jrsphoto/clevercoffee-teensy/teensy-pinout-review.md

# Teensy 4.1 pinout review (Argenta SME control board)

Phase 0 of the CleverCoffee to Teensy 4.1 + ESP32-S3 port. Reviews the Teensy pin
assignments drafted in the KiCad schematic
`clevercoffee-hardware/CleverCoffee_Teensy41_Dev_SMD/` (root sheet +
`relays.kicad_sch`), verified against the real Teensy 4.1 peripheral map. Completed and
ERC-clean 2026-10-26. This table is the source of truth for `src/hardware/pinmapping.h`.

## Method

The schematic was read as a netlist (pins matched to global labels by coordinate), not
eyeballed from the PNG. Every bus assignment was cross-checked against the Teensy core
source (PaulStoffregen/cores `teensy4/pwm.c` for the FlexPWM/QuadTimer table,
PaulStoffregen/SPI for the LPSPI4 default pins) and against the symbol's own pin-name
labels, which are taken from PJRC's pinout card.

## Final pin table (= pinmapping.h)

Teensy digital pin numbers.

| Function | Teensy pin | Peripheral used |
|---|---|---|
| Heater SSR (to ULN2003 I1) | 2 | GPIO out |
| Fill valve (to ULN2003 I4) | 3 | GPIO out |
| Group valve (to ULN2003 I3) | 5 | GPIO out |
| Pump PWM (to driver board; AC mode via Pmode jumper to ULN2003 I2) | 9 | FlexPWM2_2_B |
| Flow sensor (DM60 pulse) | 10 | QuadTimer1_0 (interrupt / input-capture) |
| SPI MOSI (both MAX31865 RTDs) | 11 | SPI (LPSPI4) MOSI |
| SPI MISO (both RTDs) | 12 | SPI MISO |
| SPI SCK (both RTDs) | 13 | SPI SCK (also onboard LED) |
| Boiler RTD chip-select | 15 | GPIO |
| Group RTD chip-select | 16 | GPIO |
| I2C SDA (encoder, PCF8574, pressure) | 18 | Wire (I2C0) SDA |
| I2C SCL (same three) | 19 | Wire (I2C0) SCL |
| Brew switch | 24 | GPIO in |
| Encoder interrupt (ENC_INT) | 25 | GPIO in (R13 pull-up) |
| Water-level probe | 26 | GPIO in (R14 pull-up) |
| HX711 data 1 (SC_DAT) | 38 | GPIO in |
| HX711 clock (SC_CLK, shared) | 39 | GPIO out |
| HX711 data 2 (SC_DAT2) | 40 | GPIO in |
| ESP32-S3 link RX (Serial1 RX1) | 0 | UART |
| ESP32-S3 link TX (Serial1 TX1) | 1 | UART |

Spare pins: D4, D6, D7, D8 (freed by removing the OLED; D7/D8 = Serial2 if a second UART
is ever wanted), plus D14, D17, D20-D23, D27-D37, D41, and the analog-only A-pins.

## Why these are correct

- All hardware buses sit on their native Teensy pins: SPI on 11/12/13, I2C (Wire) on
  18/19, Serial1 on 0/1. The RTD chip-selects (15, 16) and the native hardware CS (10,
  reused here for flow) are fine because any GPIO works as a software SPI chip-select.
- Teensy 4.1 has no boot/strapping-sensitive pins among 0-54, and its onboard SD card and
  QSPI flash are on dedicated pads that do not touch pins 0-54. No assignment collides
  with the SD or flash, and there are no boot-gotcha pins to design around.
- D10 for flow is a good pick: it is QuadTimer1_0, so it supports hardware input-capture,
  not just attachInterrupt. The DM60 runs under ~1 kHz, so even plain interrupts suffice.
- D13 doubles as the onboard LED. Standard on Teensy; the LED flickers with SPI traffic,
  which is harmless.

## Findings and how they were resolved

1. **No ESP32-S3 link pins (blocker).** The schematic had no UART anywhere. Resolved:
   added Serial1 on the free D0/D1 pair (Teensy D1 TX1 to ESP32 RX; Teensy D0 RX1 from
   ESP32 TX). Both 3.3 V, no level shifter.

2. **Pump PWM had no default-off bias (safety).** The four ULN2003 outputs are held off
   at boot by input pull-downs R15-R18, but the PWM pump path bypasses the ULN2003 and had
   no pull-down, so the driver board would see a floating input from power-on until
   firmware takes over. Resolved: added a pull-down on the PMP_PWM net. (Teensy pins power
   up as floating inputs, so this bias is what guarantees "pump off at boot.")

3. **SPI OLED was a leftover from the ESP32 Rev 1.2 board.** The new architecture puts the
   color LCD on the ESP32-S3 module; the Teensy's status indicator is the encoder RGB LED.
   Resolved: removed DISPLAY1 and its four nets, freeing D4, D6, D7, D8.

4. **Pump PWM shared a FlexPWM submodule with the old OLED backlight.** D9 (pump) is
   FlexPWM2_2_B and D6 (OLED_BL) was FlexPWM2_2_A, the same submodule, so the two would
   have shared one PWM frequency. Resolved by finding 3 (OLED removed, D6 freed), so the
   pump now owns FlexPWM2_2 alone. If a second PWM load is ever needed, these are on
   separate submodules and safe alongside the pump: D4 (FlexPWM2_0), D28/D29 (FlexPWM3_1).

## ERC notes (schematic power-pin typing)

The Teensy module sources 3.3 V on-board, which confused ERC until the power-pin types
were set correctly. The rule: every supply/ground net needs exactly one declared source,
which is either one pin set to "Power output" or one PWR_FLAG. Final state:

- **+3.3 V:** one Teensy 3V3 pin set to "Power output" (the regulator source), the other
  3V3 pins set to Passive. No PWR_FLAG needed on this rail.
- **+5 V and GND:** sourced from the power-in connector and declared by the existing
  PWR_FLAGs there. All chip GND pins stay "Power input."
- **+24 V:** appears only on the ULN2003 output/COM side and the relay headers (24 V never
  touches a Teensy pin).

Pin electrical types, in plain terms: "Power output" = supplies a voltage (one per rail);
"Power input" = consumes a supply, which is every chip VDD and every GND pin; "Passive" =
a plain connection point and the spare duplicate supply pads of a module.

## Verified on real hardware (2026-10-26)

The output pins were checked physically with a Kingst LA2016 logic analyzer on the
bench machine (`ssh bench`, `sigrok-cli -d kingst-la2016`), probing a Teensy 4.1
driven by the phase 2a bring-up console. This is the difference between the firmware
claiming a pin number and the pin actually moving, and it was done before the PCB was
fabricated, when a swap still costs nothing.

Probes: CH0 to pin 2, CH1 to pin 3, CH2 to pin 5, CH3 to pin 9, plus a ground lead to
Teensy GND (essential - the Teensy and the analyzer hang off two different computers,
so they need a shared ground reference).

**Test 1 - each channel commanded on for 2 s in turn.** Captured 20 s at 100 kHz:

```
   5.120s  1,0,0,0     on heater -> pin 2       high 2.002 s
   7.122s  0,0,0,0     off
   8.123s  0,1,0,0     on fill   -> pin 3       high 2.002 s
  10.125s  0,0,0,0     off
  11.126s  0,0,1,0     on valve  -> pin 5       high 2.003 s
  13.129s  0,0,0,0     off
  14.130s  0,0,0,1     on pump   -> pin 9       high 2.002 s
  16.132s  0,0,0,0     off
```

Every command drove exactly the intended pin and no other. **No pins are swapped**, in
either the firmware or the schematic. Only ever one channel high at a time, so the
console's one-at-a-time interlock is confirmed at the physical level rather than just
in its own status output. Hold times match the commanded 2.000 s to within 3 ms (serial
latency). Across 20 s on four channels there were exactly eight edges and no spurious
transitions, glitches or cross-talk.

**Test 2 - outputs across a reset.** Captured 25 s spanning a reset, a full reflash and
the reboot:

```
   0.000s  0,0,0,0     ... and nothing else, for the entire capture
histogram: 2,499,841 samples   all 0,0,0,0
```

Zero transitions through the running firmware, the reset into the bootloader, the flash
programming, the reboot, static initialization, `setup()`, and into the main loop. This
physically confirms the claim made in `outputs.cpp` and `safetyHandler.h`: there is no
instant at which an output is undefined or momentarily energized. Previously that was
reasoning about the i.MX RT's GPIO reset state plus the board's pulldowns; now it is
measured.

Pump PWM verified this way on 2026-11-02, with the DRV8871 connected and the
LA2016 on CH3 (Teensy D9), sampling at 10 MHz:

| commanded | measured duty | frequency |
|---|---|---|
| 10% | 10.07% | 20.14 kHz |
| 20% | 19.96% | 19.96 kHz |
| 35% | 35.10% | 19.84 kHz |
| 50% | 49.61% | 19.84 kHz |
| 75% | 75.41% | 19.67 kHz |
| 100% | static HIGH, no switching | - |

Every level within ~0.4% of commanded, and 100% correctly collapses to a
continuous high rather than a 99.98% duty. The frequency sits 0-2% under 20 kHz,
which is FlexPWM prescaler/modulus quantisation and of no consequence.

Note for anyone re-running this: the analyser enumerated as
`kingst-la2016:conn=1.16`, not the `conn=1.9` recorded in earlier notes. Scan
with `sigrok-cli --scan` rather than trusting a stored connection string.

Not yet verified this way (needs the hardware): the two RTD
chip-selects on the shared SPI bus, I2C traffic to the encoder and PCF8574, and DM60
pulse counting. Note the LA2016 also has two PWM *outputs*, which can inject synthetic
flow pulses at a known rate into pin 10 - that makes the net-new DM60 flow handler
testable dry, with no pump or plumbing.

## KiCad changes made (for the record)

1. Added a Conn_01x04 link connector; global labels UART_TX on Teensy D1, UART_RX on D0;
   connector pins labelled UART_TX (to ESP32 RX), UART_RX (to ESP32 TX), +3V3, GND.
2. Added a 10k pull-down (R19) from the pump PWM net to GND near the PUMP_PWM1 header.
3. Removed the DISPLAY1 connector, its decoupling cap, and the OLED_CS/DC/RST/BL labels.
4. Set the Teensy 3V3 regulator pin to "Power output" and the other 3V3 pins to Passive.
5. **Renamed the header-end pump label PMP_PWM to PUMP_PWM (2026-10-31).** See below.

## Found later: the pump PWM net was broken in two

Caught while writing the pump firmware, NOT during this review, which is the
part worth learning from.

The pump path had a global label at each end with a different name: `PUMP_PWM`
on the Teensy D9 side and `PMP_PWM` at the `PUMP_PWM1` header. Global labels
connect by exact name, so those were two separate nets and **D9 never reached
the driver header** - the pump would not have run at all on a fabricated board.
The 10k pull-down was also stranded on the header-side net, leaving the Teensy
pin with no default-off bias.

Fixed by renaming the header-end label to `PUMP_PWM`. Verified in the saved
file: the name now appears twice, `PMP_PWM` is gone, and R19 pulls the whole
net - including D9 - low at reset.

**Why this review missed it:** the review checked pin ASSIGNMENTS against the
Teensy's peripheral map - is D9 really FlexPWM2_2_B, does anything else share
that submodule - and never checked net CONNECTIVITY. A pin can be assigned
perfectly and still be wired to nothing. Any future pinout review should trace
each signal end to end and confirm both ends land on the same net name, not just
that the pin choice is sound.

The same check found two more labels on nets of their own with nothing driving
them, `PMP_AC` and `PMP_RL` in the relays sheet. Those are the remains of the
abandoned on/off pump path and are harmless, but can be deleted for tidiness
now that the pump is PWM-only.

## FIXED 2026-11-05: R10, R9 and the 5 V pin are all resolved

Re-read from the saved schematic files, not assumed:

| item | was | now |
|---|---|---|
| R10, flow sensor pull-up | 47K | **4K7** |
| R9, brew switch pull | 47K, with JP2 solder jumper | **10K pull-down, JP2 deleted, C5 on the signal** |
| `PUMP_PWM1` header | 3-pin, +5 V next to D9 | **2-pin JST XH, 5 V pin removed** |

All three pre-fab blockers below are therefore closed. The sections are kept
because the reasoning is worth having, but **do not act on them as if they were
outstanding.**

Still open from the sections below: nothing. The board has no known pre-fab
blockers as of 2026-11-05.

## FOUND AND FIXED 2026-11-05: the ULN2003 inputs were swapped

A fourth class of fault, and the one this review was least equipped to catch.

The three signals arrived at the wrong ULN channels. Pin assignment was
correct, every net was connected at both ends, and every component value was
right - and it was still wrong, because a multi-channel device pairs input N
with output 17-N and the nets did not respect that pairing. The result was a
three-way rotation: the heater pin would have opened the fill solenoid, the
group valve pin would have fired the heater SSR, and the fill pin would have
opened the group valve.

John fixed it on the spot. Verified correct afterwards by tracing the saved
file:

| ULN channel | input pin | net in | output pin | net out | connector |
|---|---|---|---|---|---|
| 1 | 1 (I1) | `GROUP` | 16 (O1) | `GRP_RL` | `GRP_SOL1` group valve |
| 2 | 2 (I2) | `FILL` | 15 (O2) | `FILL_RL` | `BLR_FILL1` fill solenoid |
| 3 | 3 (I3) | `HEATER` | 14 (O3) | `HTR_RL` | `HEATER_RL1` heater SSR |

Pulldowns confirmed on all three inputs: R15 on `GROUP`, R16 on `FILL`, R17 on
`HEATER`, all to the GND rail. Channels 4-7 are marked no-connect at both ends.
R18 no longer exists, which is correct now that the pump is PWM-only and only
three channels are in use.

**Why the earlier verification missed it.** The LA2016 test recorded further up
this document probed **Teensy pins 2, 3, 5 and 9 directly**. It proved the
firmware drove the pin it meant to, which was the question being asked, and it
could not have caught this because it never looked at the far side of the ULN.
The bench `ulntest` does exercise the output stage, but on hand-wired
breadboard connections rather than the PCB's netlist.

**The check to add to any future review:** for every multi-channel part, confirm
the input and output of the SAME channel carry the same signal. Four things to
check now, not three: pin assignment, net connectivity, component values
against the connected part's datasheet, and **channel pairing through
multi-channel devices.**

## Reasoning kept for the record: R10, the flow sensor pull-up, was 47k

The DM60's datasheet requires a pull-up of **1.2k to 4.7k** on its
open-collector signal pin, depending on supply voltage. R10 on this board is
**47k** - between 10 and 40 times too weak.

Consequence, measured on the breadboard with the Teensy's own ~22k internal
pull-up standing in: the signal line sits LOW permanently. The sensor's output
transistor pulls it down, and the weak pull-up cannot bring it back up between
pulses, so there is no high state to fall from and the falling-edge interrupt
almost never fires. With water flowing at a good rate the firmware counted
**4 pulses in 30 seconds**, against an expected ~40,000 pulses per litre. One
earlier run managed 215 pulses in 12 s, which is the same fault succeeding
marginally for a moment.

Nothing was wrong with the sensor, the wiring, the pump or the firmware. The
firmware counted every edge it was given, with zero debounce rejections
throughout.

**Fix:** change R10 from 47K to **2.2k**. It is already correctly placed between
+3.3 V and the FLOW net; only the value changes.

The rest of that connector is right and worth keeping: `FLOW_SENS1` feeds the
sensor +5 V while the pull-up goes to +3.3 V. That is the correct arrangement
for an open-collector output driving a pin that is not 5 V tolerant - the output
only ever sinks, so the line's high level is set by the 3.3 V pull-up and never
by the sensor's supply.

Related, not broken but worth revisiting: **R9** (brew switch pull) is also 47k,
where most other inputs on this board use 10k. A panel switch on a long lead in
a cabinet with a pump and a 1500 W heater deserves the stronger pull plus a
100 nF to ground.

**How this was missed twice:** the phase-0 review checked pin assignments and,
after the pump-net episode, net connectivity. It never checked component VALUES
against the connected part's datasheet. A pull-up can be present, correctly
placed, correctly connected, and still be the wrong value - which looks
identical to a dead sensor.

## Brew switch block, as revised 2026-11-02

JP2 deleted, R9 now 10k, C5 moved onto the signal. Final arrangement:

    R9  10k    BREW_SW -> GND      (pull-down)
    C5  0.1uF  BREW_SW -> GND      (near the connector)
    BPSW_SW1   pin1 BREW_SW, pin2 +3.3V, pin3 GND
    panel switch wired between pin 1 and pin 2

Three reasons this beats the original 47k + solder-jumper version:

1. **The solder jumper was a silent hazard.** `SolderJumper_3_Open` ships with
   no pads bridged, so a missed build step left pin 24 with NO pull at all -
   a floating input on the signal that starts a brew. Hard-wiring removes a
   step whose omission is dangerous rather than merely wrong.

2. **Pull-down fails safe on the likelier cable fault.** The line idles low and
   the switch pulls it high, so a lead chafing against grounded chassis metal -
   far more likely inside a machine than shorting to a 3.3 V wire - reads as
   NOT PRESSED. Wired the other way, that same chafe starts a shot.

3. **C5 earns its keep now.** It was decoupling the 3.3 V pin feeding a passive
   mechanical switch drawing 0.33 mA, which needed nothing. On the signal with
   10k it gives a 1 ms time constant - inside the 20 ms firmware debounce, so
   it filters induced spikes without making the switch feel slow.

The switch also uses adjacent connector pins (1 and 2), keeping the cable's
current loop tight.

**FIRMWARE CONSEQUENCE, to action when the board is built:** this board is
external pull-DOWN, active HIGH. `switchHandler` currently defaults to the
Teensy's INTERNAL pull-up and active LOW, because the breadboard has no
external resistor on this signal. When the PCB exists, change the defaults to
`Pull::External` and `setActiveHigh(true)`, or set them at runtime with
`brewpull x` then `brewsense`.

## Pull-up audit: every pin where firmware depends on a pull

Done after John asked whether anywhere the code uses an internal pull-up ought
to have an external one instead. Good instinct, and the answer is more specific
than "yes": the board already HAS external pulls nearly everywhere. Two of them
are simply the wrong value.

| Pin | Signal | External | Value | Verdict |
|-----|---|---|---|---|
Values below are as re-read from the saved schematic on 2026-11-05. The two that
were wrong have been corrected.

| Pin | Signal | External | Value | Verdict |
|-----|---|---|---|---|
| 18/19 | SDA / SCL | R7, R8 | 4k7 | correct for I2C |
| 25 | ENC_INT | R13 | 10k | fine - open-drain, short on-board trace |
| 26 | WATER probe | R14 | 10k | reasonable |
| 10 | FLOW | R10 | 4k7 | **FIXED** - was 47k, datasheet wants 1k2-4k7 |
| 24 | BREW_SW | R9 | 10k | **FIXED** - was 47k, now 10k pull-DOWN + C5 on signal |
| 9 | PUMP_PWM | R19 | 10k | pull-down, default-off bias for the pump |
| 38/40 | HX711 DAT | none | - | **not needed**, see below |

Superseded original table, kept so the "how this was missed" note below still
has something to refer to:

| Pin | Signal | External | Value | Verdict |
|-----|---|---|---|---|
| 10 | FLOW | R10 | **47k** | **WRONG** - datasheet wants 4k7, see above |
| 24 | BREW_SW | R9 | **47k** | weak for a long panel lead; 10k + 100nF better |

The HX711 is a genuine exception. Its DOUT is a push-pull CMOS output that
actively drives both high and low, so a pull-up does nothing for it. The
firmware enables the internal one purely so that an ABSENT board reads as a
defined high - which is what `weight::probeDataLine()` keys off to tell a
missing HX711 from a present one.

**The rule to apply going forward:** anything open-collector or open-drain, and
anything arriving on a cable from off-board, needs an external pull-up of a
chosen value. Teensy 4's `INPUT_PULLUP` is 22k (the core writes `PUS(3)` in
digital.c), which is adequate for a short on-board open-drain line and nowhere
near enough for a sensor whose datasheet specifies 4k7. An internal pull is a
default, not a design decision.

## RESOLVED: 5 V next to a 3.3 V-only pin

`PUMP_PWM1` is a 3-pin header: pin 1 the PWM signal, pin 2 **+5 V**, pin 3 GND.
The signal pin goes straight to Teensy D9, which is not 5 V tolerant, and it sits
immediately next to a 5 V pin. A connector inserted one position off puts 5 V on
D9 and destroys the pin or the chip.

The DRV8871 needs no logic supply - it runs from VM alone - so if nothing on the
driver board needs 5 V, the cleanest fix is to delete pin 2 and make this a
2-pin header, which removes the hazard rather than mitigating it. If a driver
board does need 5 V, use a polarised connector so it can only mate one way.

**Done, and better than asked.** `PUMP_PWM1` is now a **2-pin JST XH**
(`JST_XH_B2B-XH-A_1x02_P2.50mm_Vertical`), confirmed in the saved file. The 5 V
pin is gone, so the hazard no longer exists, and JST XH is polarised, so the
remaining two pins cannot be mated backwards either. Both fixes rather than one.
