jrsphoto/clevercoffee-teensy/assets/coffee-drink.png

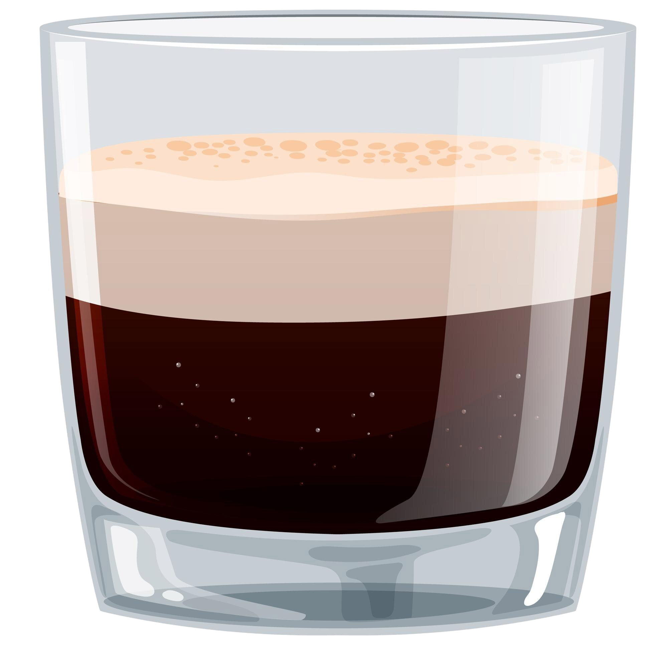
assets/coffee-drink.png
