jrsphoto/clevercoffee-teensy/src/main.cpp

/**
 * @file main.cpp
 *
 * @brief Teensy 4.1 control firmware for the Argenta SME espresso machine
 *
 * PHASE 1 SKELETON. This boots, proves the board is alive, holds everything in a
 * safe state and feeds the watchdog. It deliberately does not yet control
 * anything: the handlers are ported in later phases (see TEENSY-PORT-BRIEF.md).
 *
 * Division of labour, for anyone reading this cold:
 *   - This Teensy owns all real-time control, all physical I/O and ALL safety.
 *   - An ESP32-S3 module over Serial1 owns WiFi, the web UI and the colour LCD.
 *     It is a head only. It holds no actuators and no safety, and the machine
 *     runs and finishes shots normally with it unplugged.
 *
 * Structure follows upstream CleverCoffee on purpose: small hardware interfaces
 * (TempSensor / Relay / Switch / Scale), feature logic in xHandler modules, one
 * setup() and one loop(). The hardware layer underneath is swapped for Teensy
 * and a comms layer is added; the shape stays recognizable so upstream changes
 * remain cross-referenceable.
 */

#include <Arduino.h>

#include "bringupConsole.h"
#include "commsHandler.h"
#include "configStore.h"
#include "encoderHandler.h"
#include "flowHandler.h"
#include "hardware/outputs.h"
#include "hardware/pinmapping.h"
#include "heaterHandler.h"
#include "i2cHandler.h"
#include "pumpHandler.h"
#include "safetyHandler.h"
#include "shotHandler.h"
#include "switchHandler.h"
#include "tempHandler.h"

#ifdef DESK_SIM
    #include "boilerSim.h"
#endif
#include "updateMode.h"
#include "weightHandler.h"

// Version of the Teensy control firmware specifically. Independent of the
// upstream CleverCoffee version carried in VERSION.txt.
constexpr char kTeensyFirmwareVersion[] = "0.1.0-phase1";

namespace {

    /**
     * Serial console on the USB port. Used for bring-up and diagnostics; it is
     * NOT the ESP32 link (that is Serial1) and nothing about control depends on
     * anyone being connected to it.
     */
    constexpr uint32_t kConsoleBaud = 115200;

    /**
     * How long to wait for a USB console at boot before giving up and carrying
     * on. The machine must boot with nothing plugged in, so this is a short
     * courtesy pause for the bench, never a requirement.
     */
    constexpr uint32_t kConsoleWaitMs = 1500;

    /**
     * Main loop pacing. The real control cadence arrives with the PID in phase 3;
     * for now this just keeps the skeleton's heartbeat readable.
     */
    constexpr uint32_t kHeartbeatIntervalMs = 2000;

    uint32_t lastHeartbeatMs = 0;

    /**
     * @brief Power-on checks that must pass before the machine is allowed to do
     *        anything.
     *
     * Phase 1 only knows how to check the things that exist in phase 1. As
     * sensors land in phase 2 this grows: RTD fault flags, a plausible boiler
     * temperature, the water probe reading something valid, the I2C devices
     * acknowledging at their expected addresses.
     *
     * @return true if the machine is fit to run.
     */
    bool runBootSelfCheck() {
        bool ok = true;

        // A watchdog reset means the previous run stopped feeding the loop. That
        // is never normal, and it must be visible rather than silently absorbed
        // into what looks like a fresh power-on.
        if (safetyWasWatchdogReset()) {
            Serial.println("SELF-CHECK: previous run ended in a WATCHDOG RESET");
            safety::latchFault(FaultCode::WatchdogReset, "previous run stalled");
            ok = false;
        }

        // The boiler RTD is the one sensor the heater cannot run safely without.
        // The group probe is deliberately not checked here: it is monitoring
        // only and may not even be fitted.
        if (!temps::selfCheck()) {
            Serial.println("SELF-CHECK: boiler RTD did not return a believable reading");
            safety::latchFault(FaultCode::BootSelfCheck, "boiler RTD unavailable at boot");
            ok = false;
        }
        else {
            Serial.print("SELF-CHECK: boiler RTD reads ");
            Serial.print(temps::boilerC(), 2);
            Serial.println(" C");
        }

        return ok;
    }

    /**
     * Tracks whether a serial monitor is attached, so a fresh connection can be
     * greeted with the banner.
     *
     * The board boots and starts running long before anyone opens a monitor, so
     * anything printed only once at startup is invisible in practice - which is
     * exactly what happened on the bench: upload, open the monitor, see nothing
     * but heartbeats and wonder whether the firmware is alive.
     *
     * On Teensy, `(bool)Serial` reports whether the USB host has the port open
     * (DTR asserted), so a false->true transition is a monitor attaching.
     */
    bool consoleWasAttached = false;

    void printBanner() {
        Serial.println();
        Serial.println("========================================");
        Serial.print("CleverCoffee Teensy control firmware ");
        Serial.println(kTeensyFirmwareVersion);
        Serial.println("Argenta SME - Teensy 4.1 + ESP32-S3");
        Serial.println("========================================");
        Serial.print("Safe state asserted on pins: heater=");
        Serial.print(PIN_HEATER);
        Serial.print(" pump=");
        Serial.print(PIN_PUMP);
        Serial.print(" valve=");
        Serial.print(PIN_VALVE);
        Serial.print(" fill=");
        Serial.println(PIN_FILL);
    }

    /**
     * @brief Report the current fault state in one line.
     */
    void printFaultLine() {
        if (safety::isFaulted()) {
            Serial.print("FAULT LATCHED: ");
            Serial.print(safetyFaultName(safety::latchedFault));
            Serial.print(" (");
            Serial.print(safety::latchedDetail);
            Serial.println(") - outputs blocked, 'clear' to reset");
        }
        else {
            Serial.println("no fault latched - outputs available");
        }
    }

    /**
     * @brief Greet a monitor that has just attached.
     *
     * Re-prints everything a person needs to orient themselves, so opening a
     * monitor at any point gives the full picture rather than a bare heartbeat.
     */
    void onConsoleAttached() {
        printBanner();
        Serial.print("uptime ");
        Serial.print(millis() / 1000);
        Serial.println("s");
        printFaultLine();
        temps::printStatus();
        flow::printStatus();
        switches::printStatus();
        weight::printStatus();
        pump::printStatus();
        heater::printStatus();
        shot::printStatus();
        encoder::printStatus();
        comms::printStatus();
        bringupConsolePrintHelp();
    }

} // namespace

void setup() {
    // FIRST. Before the console, before config, before any object is built.
    // Until this runs, the outputs are held off only by the board's bias
    // resistors; this takes deliberate control of them.
    safetyInitOutputs();

    Serial.begin(kConsoleBaud);

    // Checked before ANYTHING else is initialised, and read-and-cleared so a
    // crash in update mode cannot become a boot loop that stays there.
    //
    // Update mode never arms the watchdog, never starts a sensor and never runs
    // the control loop - a machine being updated is provably not controlling
    // anything, because the code that controls things was never started.
    if (updateMode::consumeRequest()) {
        const uint32_t updateWaitStart = millis();

        while (!Serial && (millis() - updateWaitStart) < kConsoleWaitMs) {
        }

        updateMode::runLoop(); // does not return
    }

    const uint32_t consoleWaitStart = millis();

    while (!Serial && (millis() - consoleWaitStart) < kConsoleWaitMs) {
        // Wait briefly for a bench console, but never block a real boot on it.
    }

    printBanner();

    // Hardware before the self-check, because the self-check tests it.
    //
    // These were previously constructed AFTER runBootSelfCheck(), so the boiler
    // RTD was always still a null pointer when the check ran - it reported the
    // sensor unavailable and latched the machine safe on every single boot, even
    // with a perfectly good probe attached. The ordering is the whole point.
    outputs::init();
    i2c::init();
    temps::init();
    flow::init();
    switches::init();
    weight::init();
    pump::init();
    heater::init();
    shot::init();

    // AFTER every handler's init(), because restoring a setting calls that
    // handler's setter and those have to be ready to receive it. Before
    // comms::init() so the machine is already running the operator's settings
    // when the first telemetry frame goes out, rather than reporting defaults
    // for a moment and then changing its mind.
#ifdef DESK_SIM
    boilersim::init();

    // The dry-fire interlock would otherwise block the heater forever and the
    // model would never warm up. Reuse the EXISTING documented bypass rather
    // than adding a second way through the interlock - one path through that
    // gate is enough, and this one already announces itself loudly. It is
    // honest here: there is no element, and no SSR is even connected.
    heater::setBenchOverride(true);
#endif

    configStore::begin();

    comms::init();

    if (encoder::init()) {
        Serial.println("encoder: found and initialised");
    }
    else {
        Serial.println("encoder: NOT FOUND on the I2C bus");
    }

    if (!runBootSelfCheck()) {
        Serial.print("SELF-CHECK FAILED: ");
        Serial.print(safetyFaultName(safety::latchedFault));
        Serial.print(" (");
        Serial.print(safety::latchedDetail);
        Serial.println(")");
        Serial.println("Machine is LATCHED SAFE. Outputs stay off until the fault is cleared.");
    }
    else {
        Serial.println("SELF-CHECK PASSED");
    }

    // Started last, so a slow but legitimate boot cannot trip it, and before the
    // first loop() so the running machine is always covered.
    safety::noteControlLoopAlive();
    safetyWatchdogInit();

    Serial.println("Watchdog armed. Entering main loop.");

    bringupConsoleBegin();
}

void loop() {
    // Tell the safety layer the control loop is alive and its data is fresh.
    // The heater drive (phase 3) refuses to energize if this goes stale, so a
    // hung loop drops the heater rather than leaving the SSR commanded on.
    safety::noteControlLoopAlive();

    // --- Phase 2 onwards, in roughly this order: -------------------------
    // loopWaterLevel();     // dry-fire interlock, gates the heater
    // loopPressure();       // brew pressure
    // loopFlow();           // DM60 pulse counter -> volume
    // loopEncoder();        // Duppa gestures + RGB machine status
    // loopComms();          // telemetry out, commands in, non-blocking

#ifdef DESK_SIM
    // BEFORE temps::loop(), so the rise this pass adds is current rather than
    // one pass stale. Driven by the real heater output pin - see boilerSim.h.
    boilersim::loop();
#endif

    // Both RTDs. Latches the machine safe on a boiler sensor fault, an
    // implausible boiler reading, an over-temperature, or a boiler reading that
    // has stopped updating.
    temps::loop();

    // DM60 pulse counter -> volume and rate. Counting is interrupt-driven; this
    // only derives the rate and decides when flow has stopped.
    flow::loop();
    flow::serviceWatch();

    // Hardwired brew switch. Reads and debounces only - nothing acts on it
    // until the brew state machine lands in phase 3.
    switches::loop();
    switches::serviceWatch();

    // Pump speed: services the ramp AND the command-expiry rule, so it has to
    // run every pass even when the pump is idle - that is what catches a
    // wedged caller that stopped re-asserting its speed.
    // Boiler PID. Computes continuously; the output is gated and the ISR
    // refuses to energise on a permit this does not keep refreshing.
    heater::loop();
    heater::serviceOutputDutyMeasurement();

    // Brew sequence. Re-asserts the pump every pass on purpose, so a hang
    // here lets the pump's own command expiry stop it.
    shot::loop();

    pump::loop();

    // HX711 load cell. Non-blocking: drives its own stabilise/tare sequence
    // and then one conversion per pass as the chip makes them available.
    weight::loop();

    // Non-blocking encoder INT watch (bring-up aid).
    i2c::serviceEncoderIntWatch();

    // Duppa encoder: gestures and the RGB machine-status LED.
    encoder::loop();

    // Link to the display head. Telemetry out, commands in. Never blocks, and
    // never gates anything - a missing head is not a machine fault.
    comms::loop();

    // Deferred EEPROM write for settings pushed over the link. Coalesces the
    // burst the head sends on handshake into a single write.
    configStore::loop();

    if (safety::isFaulted()) {
        // Belt and braces. The fault path already forced everything off; this
        // re-asserts it every pass so no later code can quietly undo it.
        safetyHardOff();
    }

    // Greet a monitor that has just been opened. Without this the banner is
    // only ever printed at boot, which in practice nobody is connected to see.
    if (const bool consoleAttached = static_cast<bool>(Serial); consoleAttached != consoleWasAttached) {
        consoleWasAttached = consoleAttached;

        if (consoleAttached) {
            onConsoleAttached();
        }
    }

    // Bench bring-up: one output at a time, auto-off, nothing while faulted.
    // Also enforces the auto-off timer, so it must run even when nobody types.
    bringupConsoleLoop();

    // One-line status, repeated so the bench always shows the whole machine.
    //
    // This used to print just "alive, uptime 140s, state safe-idle", which is
    // the worst of both worlds: frequent enough to scroll everything useful out
    // of a serial monitor, while saying nothing you would want to know. Every
    // sensor now reports on the same line, so a monitor opened at any moment
    // shows the current state of the machine without typing anything.
    //
    // Suppressed while a channel is energized from the console, so it cannot
    // scroll an auto-off warning off the screen.
    if (const uint32_t now = millis(); now - lastHeartbeatMs >= kHeartbeatIntervalMs) {
        lastHeartbeatMs = now;

        if (outputs::activeCount() == 0) {
            Serial.print(now / 1000);
            Serial.print("s ");
            Serial.print(safety::isFaulted() ? safetyFaultName(safety::latchedFault) : "safe-idle");

            // Temperatures, with a marker rather than a plausible number when
            // the probe is unhealthy - a bad reading must not look like a good
            // one at a glance.
            Serial.print(" | boiler ");

            if (temps::boilerHealthy()) {
                Serial.print(temps::boilerC(), 1);
                Serial.print("C");
            }
            else {
                Serial.print("FAULT");
            }

            Serial.print(" group ");

            if (temps::groupHealthy()) {
                Serial.print(temps::groupC(), 1);
                Serial.print("C");
            }
            else {
                Serial.print("--");
            }

            Serial.print(" | brew ");
            Serial.print(switches::brewRequested() ? "PRESSED" : "off");

            Serial.print(" | scale ");

            if (weight::healthy()) {
                Serial.print(weight::grams(), 1);
                Serial.print(weight::calFactor() == 1.0f ? " raw" : " g");
            }
            else if (weight::present()) {
                Serial.print("starting");
            }
            else {
                Serial.print("--");
            }

            Serial.print(" | flow ");
            Serial.print(flow::rateMlPerSec(), 1);
            Serial.print(" ml/s ");
            Serial.print(flow::totalMl(), 0);
            Serial.print("ml");

            Serial.print(" | pump ");
            Serial.print(pump::actualSpeed(), 0);
            Serial.print("%");

            Serial.print(" | enc ");
            Serial.print(encoder::counter());

            Serial.print(" | head ");
            Serial.print(comms::peerPresent() ? "ok" : "--");

            Serial.println();
        }
    }

    // Last statement in the loop on purpose: everything above has to have had a
    // chance to run for this pass to count as healthy.
    safetyWatchdogFeed();
}
