jrsphoto/clevercoffee-teensy/src/heaterHandler.cpp

/**
 * @file heaterHandler.cpp
 *
 * @brief Boiler PID and the heater SSR drive
 */

#include "heaterHandler.h"

#include <Arduino.h>
#include <PID_v1.h>

#include "hardware/outputs.h"
#include "hardware/pinmapping.h"
#include "safetyHandler.h"
#include "tempHandler.h"

namespace heater {

    namespace {

        // --- PID state. The library takes pointers, so these must outlive it.
        double pidInput = 0.0;
        double pidOutput = 0.0;
        double pidSetpoint = kDefaultSetpointC;

        double tuneKp = kDefaultKp;
        double tuneTn = kDefaultTn;
        double tuneTv = kDefaultTv;

        double kiFromTn() {
            return (tuneTn == 0.0) ? 0.0 : (tuneKp / tuneTn);
        }

        double kdFromTv() {
            return tuneKp * tuneTv;
        }

        PID bPID(&pidInput, &pidOutput, &pidSetpoint, kDefaultKp, kDefaultKp / kDefaultTn, kDefaultKp * kDefaultTv, 1, DIRECT);

        IntervalTimer windowTimer;

        /**
         * The permit, and the stamp that makes it perishable.
         *
         * Both written by the main loop and read by the ISR. Volatile because
         * of that, and 32-bit so each is read atomically on this core - the ISR
         * can never see half of an update.
         */
        volatile bool permitGranted = false;
        volatile uint32_t permitStampMs = 0;

        /** Duty the ISR compares the tick counter against, 0-1000. */
        volatile uint32_t isrDutyPerMille = 0;

        /** Set once the monitor pin is known to be wired; see armOutputMonitor(). */
        volatile bool ulnMonitorArmed = false;
        volatile uint32_t isrUlnMismatches = 0;

        volatile uint32_t isrTicks = 0;
        volatile uint32_t isrOnTicks = 0;
        volatile uint32_t isrCounter = 0;

        bool masterEnable = false;
        bool benchOverrideOn = false;
        const char* gateReason = "not enabled";

        /**
         * @brief Drive the heater pin directly. ISR-safe.
         *
         * Raw pin writes rather than the Relay object, for the same reason
         * safetyHardOff() uses them: this runs in interrupt context and must
         * not depend on any other part of the firmware being in a good state.
         * The channel is HIGH_TRIGGER through the ULN2003, so HIGH = conducting.
         */
        inline void driveHeater(const bool on) {
            digitalWriteFast(PIN_HEATER, on ? HIGH : LOW);
        }

        /**
         * @brief Window timer tick, every kTickMs.
         *
         * Deliberately tiny and free of anything that could block. It does not
         * evaluate the safety gates - that would mean calling into half the
         * firmware from an interrupt - but it does not blindly trust them
         * either: a permit older than kPermitTimeoutMs is treated as absent, so
         * a main loop that has stopped refreshing it drops the heater without
         * the ISR needing to know why.
         */
        void onTick() {
            ++isrTicks;

            const uint32_t now = millis();
            const bool permitFresh = (now - permitStampMs) <= kPermitTimeoutMs;

            if (!permitGranted || !permitFresh) {
                driveHeater(false);
                isrCounter = 0;

                return;
            }

            // Upstream's comparison, unchanged: the counter walks the window in
            // kTickMs steps and the output is scaled to the same units.
            const bool on = (isrDutyPerMille > isrCounter);

            driveHeater(on);

            if (on) {
                ++isrOnTicks;
            }

            // Verify the output stage on EVERY tick, not just on demand.
            //
            // This replaced a diagnostic that sampled the monitor pin once per
            // main-loop pass and read 13% high - loop timing is not uniform, so
            // samples do not land evenly across the window. Sampling here is
            // exact by construction: one reading per tick, always at the same
            // point after the pin is driven.
            //
            // It also turns a manual test into continuous monitoring. A ULN
            // channel that dies mid-shot now shows up in the mismatch count
            // rather than as a boiler that quietly stops heating.
            if (ulnMonitorArmed) {
                // The Darlington switches in about a microsecond; give it a
                // couple before believing the reading.
                delayMicroseconds(2);

                // Output is inverted: driven high means the output sinks low.
                if ((digitalReadFast(kPinHtrRlMonitor) == LOW) != on) {
                    ++isrUlnMismatches;
                }
            }

            isrCounter += kTickMs;

            if (isrCounter >= kWindowMs) {
                isrCounter = 0;
            }
        }

        /**
         * @brief Evaluate every gate. Main-loop context, so it may do real work.
         *
         * Order matters only for the message: the first failure is what gets
         * reported, so the most fundamental reasons are checked first.
         */
        bool evaluateGates() {
            if (!masterEnable) {
                gateReason = "not enabled ('heater on' to enable)";

                return false;
            }

            if (safety::isFaulted()) {
                gateReason = "fault latched";

                return false;
            }

            if (!safety::boilerSensorHealthy) {
                gateReason = "boiler sensor not healthy";

                return false;
            }

            if (!temps::boilerHealthy()) {
                gateReason = "boiler RTD faulted or stale";

                return false;
            }

            // Belt and braces against the over-temperature limit. tempHandler
            // already latches a fault on this, which gate 2 would then catch -
            // but the heater should not depend on another module having
            // reacted first.
            if (temps::boilerC() >= temps::overTempLimitC()) {
                gateReason = "boiler over temperature";

                return false;
            }

            // DRY-FIRE INTERLOCK. There is no water-level probe circuit yet, so
            // the honest answer to "is there water?" is "unknown", and unknown
            // must mean no. See the header - do not default this to true.
            if (!benchOverrideOn) {
                gateReason = "no water-level probe (dry-fire interlock)";

                return false;
            }

            gateReason = "ok";

            return true;
        }

    } // namespace

    void init() {
        // The pin is already safe - safetyInitOutputs() ran first - but make
        // the ownership explicit before the timer can touch it.
        pinMode(PIN_HEATER, OUTPUT);
        digitalWriteFast(PIN_HEATER, LOW);

        permitGranted = false;
        permitStampMs = 0;
        isrDutyPerMille = 0;
        isrCounter = 0;

        // Upstream's configuration, unchanged. Output is scaled to the window
        // in milliseconds so the ISR can compare it straight against its tick
        // counter without converting anything in interrupt context.
        bPID.SetSampleTime(static_cast<int>(kWindowMs));
        bPID.SetOutputLimits(0, static_cast<double>(kWindowMs));
        bPID.SetIntegratorLimits(0, kDefaultIntegratorMax);
        bPID.SetSmoothingFactor(kDefaultEmaFactor);
        bPID.SetTunings(tuneKp, kiFromTn(), kdFromTv());
        bPID.SetMode(AUTOMATIC);

        windowTimer.begin(onTick, kTickMs * 1000);

        Serial.print("heater: PID ready, setpoint ");
        Serial.print(pidSetpoint, 1);
        Serial.print(" C, window ");
        Serial.print(kWindowMs);
        Serial.print(" ms / ");
        Serial.print(kTickMs);
        Serial.print(" ms tick, OUTPUT DISABLED (");
        Serial.print(gateReason);
        Serial.println(")");
    }

    void loop() {
        // Feed the PID the real temperature regardless of whether the output
        // is allowed to do anything. Running it continuously means the duty it
        // reports is meaningful the instant heating is permitted, and it keeps
        // the whole path exercised while the element is disconnected.
        pidInput = temps::boilerC();
        bPID.Compute();

        const bool allowed = evaluateGates();

        // Publish to the ISR. The duty goes out first so the ISR can never see
        // a fresh permit paired with a stale duty.
        isrDutyPerMille = allowed ? static_cast<uint32_t>(pidOutput) : 0;
        permitGranted = allowed;
        permitStampMs = millis();

        // Nothing re-asserts the output here. If this function stops being
        // called the stamp goes stale and the ISR drops the heater on its own,
        // which is the entire point of the expiry.
    }

    bool setEnabled(const bool on) {
        if (!on) {
            masterEnable = false;
            permitGranted = false;
            isrDutyPerMille = 0;
            driveHeater(false);

            Serial.println("heater: DISABLED");

            return true;
        }

        if (safety::isFaulted()) {
            gateReason = "fault latched";

            Serial.println("heater: REFUSED - clear the latched fault first");

            return false;
        }

        masterEnable = true;

        // Re-evaluate before reporting. gateReason is otherwise a pass behind,
        // so enabling the heater printed "blocked - not enabled" immediately
        // after enabling it. A status line that contradicts the thing you just
        // did teaches people to ignore status lines.
        evaluateGates();

        Serial.println("heater: master enable ON - the other gates still apply");
        printStatus();

        return true;
    }

    bool enabled() {
        return masterEnable;
    }

    void setBenchOverride(const bool on) {
        benchOverrideOn = on;

        if (on) {
            Serial.println();
            Serial.println("*** DRY-FIRE INTERLOCK OVERRIDDEN ***");
            Serial.println("The water-level probe is bypassed. This is for confirming the SSR");
            Serial.println("drive with NO HEATING ELEMENT CONNECTED. Do not leave it set, and");
            Serial.println("do not energise an element in a boiler whose water level is unknown.");
            Serial.println("Not persisted - a reboot clears it.");
            Serial.println();
        }
        else {
            Serial.println("heater: dry-fire interlock restored");
        }
    }

    bool benchOverride() {
        return benchOverrideOn;
    }

    double dutyPercent() {
        return (pidOutput * 100.0) / static_cast<double>(kWindowMs);
    }

    double rawOutput() {
        return pidOutput;
    }

    double setpointC() {
        return pidSetpoint;
    }

    void setSetpointC(const double celsius) {
        // Clamped well under the over-temperature limit. A setpoint above it
        // would mean the PID asking for heat the gates must then refuse -
        // the machine fighting itself, and confusing to debug.
        const double ceiling = temps::overTempLimitC() - 5.0;

        if (celsius < 20.0 || celsius > ceiling) {
            Serial.print("heater: REFUSED - setpoint must be 20 to ");
            Serial.print(ceiling, 1);
            Serial.println(" C");

            return;
        }

        pidSetpoint = celsius;

        Serial.print("heater: setpoint now ");
        Serial.print(pidSetpoint, 1);
        Serial.println(" C");
    }

    void setTunings(const double kp, const double tn, const double tv) {
        tuneKp = kp;
        tuneTn = tn;
        tuneTv = tv;

        bPID.SetTunings(tuneKp, kiFromTn(), kdFromTv());

        Serial.print("heater: tunings Kp ");
        Serial.print(tuneKp, 2);
        Serial.print(" Tn ");
        Serial.print(tuneTn, 2);
        Serial.print(" Tv ");
        Serial.print(tuneTv, 2);
        Serial.print("  (Ki ");
        Serial.print(kiFromTn(), 4);
        Serial.print(" Kd ");
        Serial.print(kdFromTv(), 2);
        Serial.println(")");
    }

    void tunings(double* kp, double* tn, double* tv) {
        *kp = tuneKp;
        *tn = tuneTn;
        *tv = tuneTv;
    }

    bool permitted() {
        return permitGranted;
    }

    const char* blockedBy() {
        return gateReason;
    }

    uint32_t tickCount() {
        return isrTicks;
    }

    uint32_t onTickCount() {
        return isrOnTicks;
    }

    namespace {

        bool measuring = false;
        uint32_t measureUntilMs = 0;
        uint32_t measureTicksAtStart = 0;
        uint32_t measureOnTicksAtStart = 0;
        uint32_t measureMismatchAtStart = 0;
        double measureDutyAsked = 0.0;
        uint32_t measureAskedSamples = 0;

    } // namespace

    void startOutputDutyMeasurement(const uint32_t seconds) {
        pinMode(kPinHtrRlMonitor, INPUT_PULLUP);
        ulnMonitorArmed = true;

        measuring = true;
        measureUntilMs = millis() + (seconds * 1000);
        measureTicksAtStart = isrTicks;
        measureOnTicksAtStart = isrOnTicks;
        measureMismatchAtStart = isrUlnMismatches;
        measureDutyAsked = 0.0;
        measureAskedSamples = 0;

        Serial.print("heater: measuring for ");
        Serial.print(seconds);
        Serial.println("s, counting ISR ticks and checking the ULN on each one...");
    }

    void serviceOutputDutyMeasurement() {
        if (!measuring) {
            return;
        }

        // Only the ASKED duty is sampled from the loop; the measured duty comes
        // from the ISR's own tick counters, which cannot be biased by loop
        // timing the way a loop-rate sampler is.
        measureDutyAsked += dutyPercent();
        ++measureAskedSamples;

        if (static_cast<int32_t>(millis() - measureUntilMs) < 0) {
            return;
        }

        measuring = false;

        const uint32_t ticks = isrTicks - measureTicksAtStart;
        const uint32_t onTicks = isrOnTicks - measureOnTicksAtStart;
        const uint32_t mismatches = isrUlnMismatches - measureMismatchAtStart;

        if (ticks == 0 || measureAskedSamples == 0) {
            Serial.println("heater: no ticks observed - is the timer running?");

            return;
        }

        const double measured = (100.0 * static_cast<double>(onTicks)) / static_cast<double>(ticks);
        const double asked = measureDutyAsked / static_cast<double>(measureAskedSamples);

        Serial.print("  duty ");
        Serial.print(measured, 2);
        Serial.print("% over ");
        Serial.print(ticks);
        Serial.print(" ticks, PID asked ");
        Serial.print(asked, 2);
        Serial.print("%, error ");
        Serial.print(measured - asked, 2);
        Serial.println(" points");

        Serial.print("  ULN output disagreed with the commanded state on ");
        Serial.print(mismatches);
        Serial.print(" of ");
        Serial.print(ticks);
        Serial.println(" ticks");

        if (mismatches == 0) {
            Serial.println("  PASS - the output stage followed every tick.");
        }
        else {
            Serial.println("  *** FAIL - the ULN output did not follow the drive. ***");
        }
    }

    bool testOutputStage() {
        pinMode(kPinHtrRlMonitor, INPUT_PULLUP);

        // Stop the window timer briefly so the ISR cannot fight this test for
        // the pin. Restarted before returning, whatever the outcome.
        windowTimer.end();

        Serial.print("heater: testing the ULN2003 output stage (pin ");
        Serial.print(PIN_HEATER);
        Serial.print(" drives net HEATER -> ULN -> net HTR_RL -> pin ");
        Serial.print(kPinHtrRlMonitor);
        Serial.println(")");

        // Input LOW: the Darlington is off, the output floats, and the
        // internal pull-up should bring the monitor pin high.
        driveHeater(false);
        delayMicroseconds(500);
        const int offState = digitalRead(kPinHtrRlMonitor);

        // Input HIGH: the Darlington conducts and should pull the output to
        // near ground against the pull-up.
        driveHeater(true);
        delayMicroseconds(500);
        const int onState = digitalRead(kPinHtrRlMonitor);

        driveHeater(false);

        windowTimer.begin(onTick, kTickMs * 1000);

        Serial.print("  HEATER low   -> HTR_RL reads ");
        Serial.println(offState == HIGH ? "HIGH (floating, pulled up)  as expected" : "LOW   <-- WRONG");
        Serial.print("  HEATER high  -> HTR_RL reads ");
        Serial.println(onState == LOW ? "LOW  (sinking)              as expected" : "HIGH  <-- WRONG");

        const bool pass = (offState == HIGH) && (onState == LOW);

        if (pass) {
            Serial.println("  PASS - the output stage inverts correctly.");

            return true;
        }

        Serial.println("  *** FAIL - the ULN2003 is not switching as expected. ***");

        if (offState == LOW && onState == LOW) {
            Serial.println("  HTR_RL stuck low: check the chip has GND on pin 8, and that");
            Serial.println("  nothing else is holding that net down.");
        }
        else if (offState == HIGH && onState == HIGH) {
            Serial.println("  HTR_RL never sinks. In order of likelihood:");
            Serial.println("   1. the monitor jumper is not fitted - an unconnected pin reads");
            Serial.println("      exactly like this. It must land on net HTR_RL.");
            Serial.println("   2. net HEATER is not reaching the ULN input.");
            Serial.println("   3. the chip has no supply or ground, or is dead.");
            Serial.println("  HTR_RL is the heater's output. GRP_RL and FILL_RL are the others.");
        }

        return false;
    }

    void testPermitExpiry() {
        if (!permitGranted) {
            Serial.println("heater: not currently permitted - nothing to expire. Enable it first.");

            return;
        }

        const uint32_t onBefore = isrOnTicks;
        const uint32_t ticksBefore = isrTicks;

        Serial.print("heater: stalling the loop for ");
        Serial.print(kPermitTimeoutMs + 300);
        Serial.println(" ms WITHOUT refreshing the permit...");
        Serial.flush();

        // Spin, exactly as a hung loop would. Not delay() - this must look
        // like the loop stopped running, and the ISR must keep firing.
        const uint32_t began = millis();

        while (millis() - began < (kPermitTimeoutMs + 300)) {
            // Deliberately empty. The watchdog is fed in loop(), which is not
            // running - the stall is well inside its 4 s bite.
        }

        const uint32_t onAfter = isrOnTicks;
        const uint32_t ticksAfter = isrTicks;
        const uint32_t elapsedTicks = ticksAfter - ticksBefore;
        const uint32_t energisedTicks = onAfter - onBefore;

        Serial.print("  ISR ran ");
        Serial.print(elapsedTicks);
        Serial.print(" ticks during the stall and energised for ");
        Serial.print(energisedTicks);
        Serial.println(" of them.");

        // The permit was fresh for the first kPermitTimeoutMs, so some
        // energised ticks at the start are correct. What matters is that it
        // stopped well before the end.
        const uint32_t expectedMax = (kPermitTimeoutMs / kTickMs) + 5;

        if (energisedTicks <= expectedMax) {
            Serial.print("  PASS - stopped after about ");
            Serial.print(energisedTicks * kTickMs);
            Serial.print(" ms, within the ");
            Serial.print(kPermitTimeoutMs);
            Serial.println(" ms permit timeout.");
        }
        else {
            Serial.println("  *** FAIL - the ISR kept energising on a stale permit. ***");
            Serial.println("  This is the protection against a hung control loop. Do not");
            Serial.println("  connect a heating element until this passes.");
        }

        driveHeater(false);
    }

    void printStatus() {
        Serial.print("heater: ");
        Serial.print(masterEnable ? "ENABLED" : "disabled");
        Serial.print(", setpoint ");
        Serial.print(pidSetpoint, 1);
        Serial.print(" C, boiler ");

        if (temps::boilerHealthy()) {
            Serial.print(temps::boilerC(), 1);
            Serial.print(" C");
        }
        else {
            Serial.print("FAULT");
        }

        Serial.print(", PID asks ");
        Serial.print(dutyPercent(), 1);
        Serial.println("%");

        Serial.print("        gates: ");
        Serial.print(permitGranted ? "PERMITTED" : "blocked");
        Serial.print(" - ");
        Serial.println(gateReason);

        Serial.print("        timer: ");
        Serial.print(isrTicks);
        Serial.print(" ticks, ");
        Serial.print(isrOnTicks);
        Serial.print(" energised, Kp ");
        Serial.print(tuneKp, 1);
        Serial.print(" Tn ");
        Serial.print(tuneTn, 1);
        Serial.print(" Tv ");
        Serial.println(tuneTv, 1);

        if (benchOverrideOn) {
            Serial.println("        *** dry-fire interlock OVERRIDDEN (bench) ***");
        }
    }

} // namespace heater
