jrsphoto/clevercoffee-teensy/src/hardware/tempsensors/TempSensor.h

/**
 * @file TempSensor.h
 *
 * @brief Interface that all temperature sensors have to implement
 */

#pragma once

#include <array>
#include <cmath>
#include <numeric>

#include "Logger.h"
#include "utils/Timer.h"

extern bool temperatureUpdateRunning;

class TempSensor {
    public:
        /**
         * @brief Abstract temperature sensor class
         * @details This class controls a temperature sensor. It updates the value in regular intervals of 400ms, controlled
         *          by a timer. The temperature sampling result is checked for errors and an internal error counter is kept
         *          to detect consecutive reading errors
         */
        TempSensor() :
            update_temperature([this] { update_temperature_reading(); }, 400) {
        }

        /**
         * @brief Returns the current temperature
         * @details Requests sampling from attached sensor and returns reading.
         * @return Temperature in degrees Celsius
         */
        double getCurrentTemperature() {
            // Trigger the timer to update the temperature:
            update_temperature();
            return last_temperature_;
        }

        double getAverageTemperatureRate() {
            // Trigger the timer to update the temperature:
            update_temperature();
            return average_temp_rate_;
        }

        /**
         * @brief Default destructor
         */
        virtual ~TempSensor() = default;

        /**
         * @brief Returns error state of the temperature sensor
         * @return true if the sensor is in error, false otherwise
         */
        [[nodiscard]] bool hasError() const {
            return error_;
        }

        /**
         * @brief Milliseconds since the last SUCCESSFUL reading.
         *
         * hasError() only goes true after max_bad_treadings_ consecutive
         * failures - several seconds at the 400 ms update rate. Until then
         * getCurrentTemperature() keeps returning the last good value, so a
         * failing sensor looks perfectly healthy and plausible to a caller.
         *
         * Safety-critical callers must use this instead: it is the only way to
         * tell "this value was just measured" from "this value is a souvenir of
         * the last time the sensor worked". Found on the bench by pulling a
         * probe lead from a running sensor, where the heater was still permitted
         * while the chip was reporting an open circuit four times a second.
         */
        [[nodiscard]] uint32_t millisSinceLastGoodReading() const {
            return millis() - last_good_reading_ms_;
        }

    protected:
        /**
         * @brief Samples the current temperature from the sensor
         * @details Requests sampling from attached sensor and returns reading. This method is purely virtual and must be
         *          implemented by every child class. The argument is passed by reference and is updated if the return value
         *          of the function is true.
         * @return Boolean indicating whether the reading has been successful
         */
        virtual bool sample_temperature(double& temperature) const = 0;

    private:
        /**
         * @brief Small helper method to be wrapped in a timer for updating the temperature from the sensors
         */
        void update_temperature_reading() {
            // Update temperature and detect errors:
            if (sample_temperature(last_temperature_)) {
                LOGF(TRACE, "Temperature reading successful: %.1f", last_temperature_);

                // Stamp the time of a genuinely successful read. See
                // millisSinceLastGoodReading() for why this matters.
                last_good_reading_ms_ = millis();

                // Reset error counter and error state
                bad_readings_ = 0;
                error_ = false;
                temperatureUpdateRunning = true;

                // Update moving average
                update_moving_average();
            }
            else if (!error_) {
                // Increment error counter
                LOGF(DEBUG, "Error during temperature reading, incrementing error counter to %i", bad_readings_);
                bad_readings_++;
            }

            if (bad_readings_ >= max_bad_treadings_ && !error_) {
                error_ = true;
                LOGF(ERROR, "Temperature sensor malfunction, %i consecutive errors", bad_readings_);
            }
        }

        Timer update_temperature;
        double last_temperature_{};
        uint32_t last_good_reading_ms_{0};
        int bad_readings_{0};
        int max_bad_treadings_{10};
        bool error_{false};

        /**
         * @brief FIR moving average filter for software brew detection
         */
        void update_moving_average() {
            if (valueIndex < 0) {
                for (int index = 0; index < numValues; index++) {
                    tempValues[index] = last_temperature_;
                    timeValues[index] = 0;
                    tempChangeRates[index] = 0;
                }
            }

            timeValues[valueIndex] = millis();
            tempValues[valueIndex] = last_temperature_;

            // local change rate of temperature
            double tempChangeRate = 0;

            if (valueIndex == numValues - 1) {
                tempChangeRate = (tempValues[numValues - 1] - tempValues[0]) / (timeValues[numValues - 1] - timeValues[0]) * 10000;
            }
            else {
                tempChangeRate = (tempValues[valueIndex] - tempValues[valueIndex + 1]) / (timeValues[valueIndex] - timeValues[valueIndex + 1]) * 10000;
            }

            tempChangeRates[valueIndex] = tempChangeRate;

            const double totalTempChangeRateSum = std::accumulate(std::begin(tempChangeRates), std::end(tempChangeRates), 0, std::plus<>());
            average_temp_rate_ = totalTempChangeRateSum / numValues * 100;

            if (valueIndex >= numValues - 1) {
                // ...wrap around to the beginning:
                valueIndex = 0;
            }
            else {
                valueIndex++;
            }
        }

        // Moving average:
        double average_temp_rate_{};
        constexpr static size_t numValues = 15;
        std::array<double, numValues> tempValues{};        // array of temp values
        std::array<unsigned long, numValues> timeValues{}; // array of time values
        std::array<double, numValues> tempChangeRates{};
        int valueIndex{-1};                                // the index of the current value
};
