jrsphoto/clevercoffee-teensy/(commit log)

2021-02-27 Water level by TOF sensor
    Adds optional TOF sensor to check water level and display fill level in %
2021-03-04 water level calibration via Blynk
2021-03-16 fix voltagesensir
2021-03-21 fixed a couple of spaces missing
2021-03-21 fix esp32
    fix esp32
2021-03-29 fix esp32 TSIC & new LIB!
    NEW TSIC LIB FOR ESP32
2021-04-04 QuickMill Startlogo
    QuickMill Startlogo (MACHINELOGO =3) erstellt und eingebunden. In userConfig.h fehlt noch der Kommentar: // 1 = Rancilio, 2 = Gaggia, 3 = QuickMill
2021-04-05 QuickMill Startlogo
    Ergänzung der Beschreibung MACHINELOGO = 3 in userConfig.h
2021-04-05 Update rancilio-pid.ino
    implement pressure sensor functionality (untested)
2021-04-05 Update userConfig.h
    implement pressure sensor config
2021-04-05 Update brewini.h
    analog input always active, used for pressure sensor
2021-04-05 Update Displaytemplatescale.h
    add pressure sensor readings on display
2021-04-09 fix pin esp8266
2021-04-11 create folder structure to support both ArduinoIDE and PlatformIO in Visual Studio Code
2021-04-13 esp32
    esp32
2021-04-22 set gitignore to ignore actual user config, create user config sample file, add script to create user config for Linux/macOS
    create multiple board version in platformio.ini
    delete userConfig.h
    Update .gitignore
2021-04-23 QuickMill steam-mode 2.0
    Code-Struktur so geändert, dass die Erkennung des Brüh- bzw. Dampfmodus für QuickMill Thermoblock im machinestate 20 erfolgt.
2021-04-25 fix show lastbezugszeit for ONLYPIDSCALE==0
    #if ONLYPIDSCALE == 1 wurde um einen Block nach unten gesetzt, damit die Bezugszeit am Ende des Brühens im Display angezeigt bleibt.
2021-05-05 set unique sample passwords, fix typos
2021-05-11 RemoteDebug added for debugging via wifi
    RemoteDebug (ttps://github.com/JoaoLopesF/RemoteDebug) in libraries aufgenommen und basis setup in ranciliop-pid.ino integriert
2021-05-11 chill-mode after steam 1.0
    Abkühlmodus "chill-mode after steam": Neuer machinestate 45 für die Abkühlphase nach dem Dampfmodus. In diesem maschinestate kann mit dem Brühschalter ein cooling flush gemacht werden oder mit dem Dampfschalter auf steam geschaltet werden.
    Wenn bis auf Solltemperatur + 2 °C abgekühlt ist, wird in den idle-Betrieb (machinestate 20) gewechselt.
    Für die QuickMill werden im machinestate 45 die PID-Werte auf Dampfeinstellungen belassen, für alle anderen Maschinen wird auf die Brüh-PID-Werte umgeschaltet.
2021-05-14 SerialDebug and RemoteDebug 1.0
    Erweiterung des Debuggings
    Neue Befehle für 5 Debuglevel (E < W < I < D < V), die auf SerialDebug.h oder RemoteDebug.h aufbauen.
2021-05-20 pid off, maschinestate 10
2021-05-20 esp32 pressure sensor & coldstart pid off
2021-05-22 DebugStreamManager 1.0
    Neue Klasse DebugStreamManager für die Debug-Ausgabe über SerialDebug oder RemoteDebug
2021-05-26 DebugStreamManager 2.0
    Erweiterung der DebugStreamManager Class um Basisklasse, damit Funktionszugriffe aus dem Debugfenster möglich sind.
    Implementierung eines Logbuchs, das die letzen MAXLOGLINES speichert. Über den Befehl loghist können die gespeicherten log-Meldungen ausgegeben werden.
2021-05-31 clean-up of userConfig.h
    moved definition of machine to rancilio-pid.ino
2021-05-31 MACHINEID
    Selection of machine via MACHINEID in order to clean-up userConfig.h (one definition rule)
    Definition of MACHINE machine is moved to rancilio-pid.ino
2021-06-03 DebugStreamManager 1.1
    delete debugFunctions.h
    delete old stuff in rancilio-pid.ino
2021-06-05 DebugSteamManager
    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
2021-06-05 Debugausgaben
    in rancilio-pid.ino Debugausgaben für DebugStreamManager angepasst
2021-06-05 Debug output of changing PID values
    Added debug output of changing PID values
2021-06-13 coldstart sensor 222
2022-06-22 Update rancilio-pid.ino
    remove BLYNK_WRITE(V7) "antiwindup", as it resets the PID output when blynk is reconnecting and sync's all variables.
2022-06-22 Move comment for VOLTAGESENSORTYPE in userConfig_sample.h to correct line
2022-06-22 update sample user config and temporarily disable isr when generating variables. static content will likely still blow up
2022-06-22 cleaned up timer1 handling (always enable with same settings)
2022-06-22 added functions to read/write system parameter values from/to EEPROM
    Since no code must be executed from Flash memory while erase/write
    operations, the EEPROM write function also handles the Timer1 interrupt.
2022-06-22 Fix enabling/disabling timer for ESP32
2022-06-22 Disable timer before SPIFFS access on ESP32
    See https://github.com/espressif/arduino-esp32/issues/1141
2022-06-22 remove pid.compute from ISR, ISR on/off from http server
2022-06-22 toggle for pid
2022-06-22 Add a simple temperature plot
2022-06-22 Add range slidder to temperature plot
2022-06-22 Platformio sample file #175
2022-06-22 Add support for blinking LED when brew temperature is in range
2022-06-22 all pid config value
2022-06-22 Sensor Error - Fix wrong Font-Size
2022-06-22 Use seconds instead of milliseconds for preinfusion pause
2022-06-22 Pin ESP8366 framework version to 2.6.3
2022-06-22 laden der eeprom Werte auf der Website
2022-06-22 fixed build issues for ESP8266 and some minor API issues
    The ESP8266 EEPROM library has far less functionality than the ESP32
    variant has. Therefore the code had to be adapted.
2022-06-22 fix message APmode und temp warning
2022-06-22 steam button
2022-06-22 removed temporary build file rancilio-pid.ino.cpp and added to .gitignore
2022-06-22 fix io sample
2022-06-22 fix pid & AP
2022-06-22 Renaming PINS to match format PIN+COMPONENT. Translation of comments
2022-06-22 Revised firmware version check
    - comparing strings at preprocessor level is not supported
    - userConfig "match check" does not include the branch name (see 1st point)
    - use separate defines for all firmware version parts to be more flexible
    - added a general function to get the version as string (w/o any other stuff)
    this function can be used to build further strings containing the firmware version
    - introduced rancilio-pid header file so that other modules may call some functions
2022-06-22 get/set "PID on" state in EEPROM
2022-06-22 Range check for MQTT parameters, set PID values via MQTT
2022-06-22 Make scale calibration factor and sample rate configurable
2022-06-22 userconfig mqtt, blynk und influx 0
2022-06-22 Dynamically update temperature on website
2022-06-22 Add chart for heater power to embedded website
2022-06-22 Add button for backflush mode to embedded website
2022-06-22 Bugfix: time format on x axis, not y axis
2022-06-22 allowed y axis zoom
2022-06-22 Bug fixed where pressure will not converge to actual value.
2022-06-27 limit integrator to smaller value to prevent overshoot (uses adapted PID library)
2022-06-27 adjust PID default values
2022-06-27 allow monitoring from platform io, show PID values
2022-06-28 allow disabling/enabling cold start pid from user config
2022-06-29 fix remote serial printf method
2022-06-29 only print current pid values if PID is enabled and new verbose flag is set
2022-07-08 Revert "use separate P, D and I form (no Tv and Tn), don't use PonM mode for cold start"
    This reverts commit dfbe010802450e451048c77e08dbd0f176d1daa5.
    # Conflicts:
    # src/rancilio-pid.cpp
2022-07-08 allow setting a temperature offset (added to measured temp)
2022-07-13 Add info text and links to parameters page, explain PID parameters
2022-07-14 update untranslated de language terms
2022-07-20 allow switching off brew detection pid while leaving bd enabled, show heating logo also when not using cold start pid
2022-07-20 print machine state using strings instead of numbers
2022-07-26 log current time for remote or local serial messages
2022-07-26 allow setting a delay time during which the PID is disabled during brews
2022-07-26 set default back to PID values from manual (no D part), enable coldstart pid values from webinterface by default, fix some comments
2022-07-27 use brew detection PID and cold start PonM PID by default again
2022-08-02 print old and new value when changing parameters
2022-08-11 move settings for PonM for cold start and BD PID to web interface
2022-08-11 only display one save button on parameters page
2022-08-23 change waiting event before mounting back to DOMContentLoaded
2022-08-23 simplify software bd stop logic, rename timerBrewdetection -> isBrewDetected
2022-08-25 get values for index page toggle buttons dynamically
2022-08-30 disable separate brew detection PID parameters by default
2022-09-01 improve visibility of save button success icon
2022-09-04 make pid toggle button on index page permanent
2022-09-05 fixes for esp32
2022-09-05 default pid to off, lower default Kp
2022-09-05 update esp platform versions for esp8266 and esp32
2022-09-06 fix typo for max value of PID kP
2022-09-22 only init dallas temp sensor object if it is actually enabled, rename userConfig var for temp pin
2022-09-26 only run moving average filter for sw brew detection if it is actually enabled
2022-10-09 rename local temp variable to not overwrite global temperature (when using pin 16 for tsic)
2022-10-10 revert to previously read temperature value when detecting sensor error
2022-10-13 always show parameter to set max brew timer value when using software bd
2022-10-13 don't show initial wrong temperature when loading index, update U8g2 dependency
2022-10-15 Fix build for ESP32
    Compilation failed for ESP32, because "timer" reference to rancilio-pid.cpp had been undefined.
2022-10-19 Update rancilio-pid.h
    To fix Cold Start Kp being too low for Quick Mill Machines
2022-11-04 move SPI OLED mode pin definitions
2022-11-04 add support for SH1106 in SPI mode
2022-11-05 properly print sensor values in case of error
2022-11-05 use ranciliopid ArduinoPID library fork
2022-11-23 pin all dependencies to current versions
2022-11-27 only apply temp offset after for checking sensor errors
2022-12-03 Update rancilio-pid.cpp
    removed duplicate "steamON" handlings in handleMachineState()
2022-12-20 fix timer display brew
2022-12-31 brew timer with standard display also include BREWSWITCHDELAY
2023-01-02 Publish water level/tof sensor data via MQTT
2023-01-21 Merge pull request #240 from judokan9/powerbutton
    Alpha 3.0.0/Added ability to turn heating on and off with an hardware switch
2023-01-22 Remove ESP8266 / ToF Sensor support
2023-01-22 Default pin mapping for ESP32 PCB
2023-01-22 Remove hardware-related files
    Hardware repository can now be found at https://github.com/rancilio-pid/clevercoffee-hardware
2023-01-24 Reorder parameters in temperature section
2023-01-29 Fixed scale pin names
2023-01-29 Changed pin mapping to match latest revision of the PCB, removed analog brew switch
2023-01-29 Added pin definitions for dimmer circuit and rotary encoder
2023-01-29 move brew PID delay parameter to web interface, reformat editableVars definition, some renames
2023-02-05 Removed redundant pin definitions for rotary encoder
2023-02-11 show heater output as % not ‰
2023-02-12 pin PID library version
2023-02-15 fix powerwitch pin parameter
2023-05-28 Add Temp LED feature again in the absence of a new status LED concept
2023-06-05 Add a configurable standby mode that turns off the heater after a certain amount of time
2023-06-27 changed heaterPower to ms
2023-10-01 adding trigger for SteamSwitch
    adding trigger for SteamSwitch
    Steamswitch has now 3 modes:
    off, switch or trigger
    removed double pinmode declaration for Steamswitch
    renaming powerswitchvoid
2023-10-03 only check steam pin if new steam switch option is enabled
2023-10-08 Reset standby timer when a brew is detected in kPidNormal state
2023-10-15 Increase maxChangeRate for TSic 306 sensor
    Increase the expected maximum temperature change rate before TSic library will throw an error
2023-10-16 use debugPrintf instead of Serial.print* and fix format string
2023-11-30 change heater power to %
2023-12-06 adding pin definitions
2023-12-09 README.md: Included that brew switch can be reconfigured to a push button
2023-12-11 Upgrade espressif platform and some libraries, switch to esphome fork of ESPAsyncWebserver
2023-12-12 rename voltagesensor
    rename VOLTAGESENSORTYPE to OPTOCOUPLERTYPE
    remove PINMODEVOLTAGESENSOR
2023-12-21 Pin library version of esphome/AsyncTCP
2023-12-26 change pinmapping.h
    change pinmapping to follow pcb development
2024-01-08 Water Sensor shown on display with icons
2024-01-08 Fixes for initial water sensor implementation
    * Remove unused function call from Displaytemplateminimal.h
    * Fix indentation and spacing
    * Add missing call of checkSteamON()
    * Remove unnecessary semicolons from display.h
    * Remove unnecessary comments
2024-01-08 Bugfix: Inonsistent Brew & Steam switch behaviours #413 #414
    Debounce on Brew trigger. Steam trigger code duplication disabled debounce. Debounce times to 20ms.
    Added variable brewSwitchLongPress and set to 500ms.
    Rename BREWSWITCHDELAY to SHOTTIMERDISPLAYDELAY, adapt comments to fit to functionality.
    Rename brewSwitchLongPress -> brewTriggerLongPress and
    lastButtonStateBrew -> lastStateBrewTrigger
    clean brewvoid
    rename a lot of variables to naming scheme
    rename var steam and power trigger
    more rename variables
2024-01-12 Clean up display templates
    * Added methods for displaying a status bar with WiFi strenght, MQTT indicator and uptime
    * Added methods for displaying heater output bar and thermometer
    * Modified minimal template to use aforementioned status bar
    * Modified temp only template: Bigger font, degree symbol and status bar
    * Modified standard and scale templates to use methods for icons, uptime and heat bar
2024-01-12 Smaller steam and brew bitmaps, bigger fonts for steam mode and shot timer
2024-01-12 Remove machine logos, display smaller heating logo and use bigger font for temperature
2024-01-14 Fix bug in state machine with low water level during backflush
    When the water level is low during backflush the pump would keep running because the state machine would go to kWaterEmpty without deactivating backflush mode
2024-01-21 Added ABP2 pressure sensor support
2024-01-21 Pressure sensor fixes
    * Remove old analog pressure sensor code
    * Move all code to pressure.h because the implementation file doesn't have a constructor
    * Use existing VERBOSE flag for serial output
2024-01-21 cleanup, removed analog press sensor from userConfig
2024-01-22 Define water sensor type separately
2024-01-22 Define shot timer type separately, make naming in userConfig_sample more consistent
2024-01-26 Added calibrationValue and knownWeight to be able to calibrate scale
    Added Option for tare and calibration through mqtt and display
    removed empty line
    added toggles for tare and calibration to web frontend
    Added Toggles for tare and Calibration to Web:
    Prepared data for KnownWeight and calibrationValue to be added
    Made scaleCalibration and scaleKnownWeight editable in Web
    Moved Scale Settings to own card
    reverted local changes in platform.ini and pinmapping to standard
    fixed merge conflicts and corrected naming of variables
    fixed bug when brewtime switches to 0 when brewing for weight
2024-01-26 Send current weight to MQTT
    Remove extra comma
    Improve calbration progress messges
    Don't tare the scale while the calibration load is very likely still on it
    Add tare and calibrate buttons to MQTT
    Fix wrong section IDs in web page
    Only include scale handlers in webserver if scale is enabled
    Remove scale related code from time-based brewing mode
    Exclude scale related code when scale is not enabled in userconfig
    Minor formatting fixes
2024-01-26 Add support for second HX711
    e8d7458531cc41ce64d7a4b8ff4c8c55c5e4a5c9
    author Fabian Sperrle <fabian.sperrle@uni.kn> 1702580259 +0100
    committer Fabian Sperrle <fabian.sperrle@uni.kn> 1705696789 +0100
    Start configuration for second HX711
    WIP: start cleanup
    Fix startup of second HX711
    Brew by weight should not stop when time is reached
    Bugfix: Set correct calibration weights for scale 2 and clean up output
    Enable HX711 library feature for more consistent readings on ESP32
    tldr: ESP32 is too fast for the library in default mode, so they added a flag that introduces timeouts and makes the readings more realiable
    Starting point for further reading: https://github.com/olkal/HX711_ADC/issues/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
2024-01-26 Cleanup & Code Style fixes
    Bugfix: Actually toggle calibration on button click
2024-01-26 Scale Bugfix: Always store both calibration factors
2024-01-27 fix verbose output pressure sensor
2024-01-27 update uPlot to current version
2024-02-06 Code Cleanup, bump version numbers
    * Removed unused code
    * Fixed formatting for else statements in accordance with style guidelines
    * Bumped versions of espressif framework, u8g2 and OneWire libraries
    * Reduce debug output of pressure sensor reading to once per second
2024-02-08 Cleaned up project structure
    * Created subfolders for hardware (sensors, switchs, etc.) and display (templates, bitmaps)
    * Renamed some header files and classes in accordance with C/C++ naming conventions
    * Clean up remaining formatting issues
2024-02-25 fix Home Assist Autodiscovery for sensor/machineState
2024-02-25 Bugfix for Backflush not stopping when having Brew-switch configured as trigger
2024-03-02 Add classes for handling GPIO Pins, Switches, Relays and LEDs
2024-03-02 Hardware abstraction for temperature sensors
2024-03-02 Improvements for Temp, GPIO, Switch and Relay
    * Temp/TSic: start measuring
    * Temp/Dallas: move handlers into class
    * Temp: document base class
    * GPIO: move pin types into class
    * GPIO: document class
    * Relay: move type into class
    * Relay: document class
    * Switch: move type into class
2024-03-02 New Logger
    * Add new library
    * Switch logging statements to new Logger
    * Add default log level to userconfig
    * Add IFLOG macro to control code blocks
    * Replace VERBOSE flag with appropriate log levels
    * Drop orphaned function
2024-03-02 Minor improvements for HAL
    * Move LED type enum into class
    * Add comments for abstract LED class
    * Fix standby bug in conjunction with power switch feature
    * Add GPIO pin for water sensor
2024-03-02 Fixed default setting for steam switch
2024-03-03 make sure the shot timer also shows when still in kAtSetpoint
2024-03-05 change max PID Value
    Values where limited on website, so values from Handbook aren´t usable
2024-03-10 Optocoupler: do not use GPIOPin::Type values put Arduino values
2024-03-10 Add option for normally-open and normally-closed GPIO Switches
2024-03-19 Sort includes, add missing STL include to IOSwitch
2024-03-19 Bitmaps: protect layout by switching formatting off
2024-04-12 Add new logic for showing the heating logo
2024-04-13 Dopr pidMode as the PID state is available from the PID object itself
2024-04-13 Switch: improve basic class
2024-04-13 Add Timer Utility
2024-04-13 Use Timer for water loop
2024-04-14 Reduce Timer Verbosity
2024-04-14 Make Water Sensor an IOSwitch
2024-04-16 Display: simplify updating display, machine state is directly called from printscreen
2024-04-16 Display: also move shot timer into printscreen routine to handle consistently
2024-04-21 Hotfix: Fix PID Mode after Startup
    This fixes a typo introduced in d0fbb59ffbf89264d5d70d65fae11cdf2ab35684
2024-04-22 Improve timer class
2024-04-22 Replace logbrew PeriodicTrigger with Timer
2024-04-22 MQTT: use timer for hassio discovery messages
2024-04-22 Display: use timer for updating
2024-04-22 Timer: allow to pause and resume
2024-05-04 TempSensor: move error checking & timer into its class
2024-05-12 Fix emergency temperature to 145
2024-05-21 Exit kSteam mode when steam button is switched off
2024-10-10 adding backflush to MQTT
    add backflush editable vars to MQTT
    add backflush to HA Discovery
    cleanup ha discovery to be more verbose with publish
    remove defaults in sensor/number device, they are to diffrent, default isn´t usefull
    remove backflush from userconfig_sample
2025-01-29 Switched from pkg_resources to importlib, since pkg_resources has been removed as of Python 3.12.
2025-03-19 Misposition of temperature display between 99.5° and 99.9° Fixes #521
2025-04-29 rename Feature_Water_Sens
    rename water tank sensor in total
    -> FEATURE_WATERTANKSENSOR
    -> waterTankFull/waterTankEmpty
    -> kWaterTankEmpty
2025-04-29 Add button to reset WiFi settings
2025-05-11 Enhance vertical template to support some symbols
    The vertical template does not support the water sensor or other symbols. This code adds support for the offline, emptywater and heating icon
    Clang formated
2025-05-28 fix pid off on brew detection
    when detecting a brew and disabling the PID, the pidOutput needs to be set to 0 and the heater shut off manually
    previously the heating continued on its last set intensity for the time set in brewPIDDelay
2025-05-29 Fix PonM mode for PID controller
    The PID controller was still using the P and I values of the old cold
    start mode which has since been removed. This commit refactors the
    method that sets the PID tunings so that it takes PonM into account
    when enabled.
2025-06-01 Rework Brew Controll
    remove brewdetection
    adds brewtimer without controlling pump/valve
    add manual flush as own function
    manual flush with own mashineState kManualFlush
    add manualFlush to display templates and shottimer
    rework brew() and backflush()
    bring brewcontrol setting onto website
    clean up MQTT Brew stuff
    adding case kInteger to assignMQTTParam() so backflushCycles could be changed thru MQTT
    bring display settings onto the website
    rename some scale vars to be more precice
    add weightBrewed to MQTT sensors and HA auto discovery
    rename Shot timer, manual flush timer separated
    a own function to check if brew timer should be visible or not, based on brew is running
    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
2025-06-02 Add support for Steam LED, added feature flag to initialisation
    - Updated LED initialisation to include enable and inversion flags
    - Added support for steamLED
    - Introduced `setGPIOState()` helper to handle GPIO logic cleanly
    - Added feature flag to manage LED enable/invert behavior
2025-06-09 Added #if to steam LED initialisation and usage due to conflicts with TX0 pin
2025-06-10 if no brewswitch configured, switch should not be checked
2025-06-20 Added upload function for config.json backups
    * Use proper bool values in config.json
    * Add a upload function to About page
    * Validate config structure and parameter ranges
    * Save config if validation passes and reboot in either case
2025-06-20 Add endpoint and corresponding button for restarting the machine
2025-06-20 removed FEATURE_ references, set TARE_ON and CALIBRATE_ON to return true so they show in main screen
2025-06-20 Use JSON path as ID in ParameterRegistry, fix config upload
    * Instead of unique IDs for Parameters, use the JSON path, e.g.
    "pid.enabled" instead of "PID_ON"
    * Added missing OLED parameters to config upload validation
    * Added user feedback on the About page when validation fails
2025-06-20 Fix toggles and temperature input on home page
2025-06-20 Refactored Config.h to get rid of hard-coded getters and setters
    Added factory reset button on about page
2025-06-20 Avoid temporary strings in template getter and setter methods to prevent heap corruption
    Tweak visibility settings of brew-related parameters if brew switch is enabled/disabled
2025-06-23 fixed reading second scale as it would pause often due to shared clock pin
2025-06-23 Update espressif framework and several libraries
    * Increase espressif32 platform version to 6.11.0
    * Update ArduinoJson to 7.4.2, fix breaking changes
    * Update U8g2 library to 2.36.9
    * Update ESPAsyncWebServer to 3.7.8
    * Update ESPAsyncTCP to 3.4.4
    * Update DallasTemperature to 4.0.4
2025-06-27 Make hardware parameters web-configurable
    * Added all hardware config items to ParameterRegistry
    * Added new sections for hardware-related Parameters
    * Introduced a filter parameter to be able to show parameters on
    different web pages
2025-06-27 Replace on/off buttons on home page with Bootstrap form-switches
2025-06-27 Fix setting the i2c address of the OLED display
    * The u8g2 library expects 8 bit addresses, not 7 bit. Which is why the
    method call wasn't working
    * Use an enum type for ParameterRegistry because there are essentially
    only 2 possible addresses in the wild
2025-06-27 Fix wrong endpoint for scale calibration in app.js
2025-06-27 Fix triggering scale tare and calibration functions on home page
    * Use buttons instead of form toggles because tare and calibration
    cannot be meaningfully cancelled once they're triggered
    * Add some visual separation between the core and the scale functions
    * Fix alignment of toggles and buttons
2025-07-02 Added process flags to reduce stuttering, added MQTT filter to only send what has changed. Added tickbox in parameters webpage to enable loop timing in console logs DEBUG mode.
2025-07-02 Changed defaults and config reference files to align Added line in app.js to refresh page with new filtering
2025-07-03 handle valve turn off states, removed brew() outside of machineStates added check functions
2025-07-03 Changed to brewHandler template, added full screen timer added bitmap water drop, fixed issues with standby
2025-07-06 Fix display of brew/flush timer and weight in display templates
2025-07-06 Prevent brew switch input while hot water is running
2025-07-06 Use power switch to enter standby mode immediately
    * Enter standby mode when power switch is pressed/toggled
    * Stop running brew or hot water
    * Turn off display
    * Suppress other switch inputs
2025-07-06 Fix momentary power switch operation
2025-07-06 Fixed momentary switch not working in some modes. Fixed valve being disabled during flush. Added initial state that varies with mode
2025-07-06 Added reboot on long press of momentary power switch
2025-07-06 Prevent reboot loop for momentary power switches with the wrong switch mode
2025-07-06 Print changed loglevel in readable text
2025-07-08 changed machineStates for hot water, added water on timer, standby remaining time, changed webserver memory allocation to avoid buffer resizing in AsyncResponseStream causing crashes, added initial s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
2025-07-13 added font size and langstrings for calibration and added a wrapped message function to displayCommon. Fixed UTF8 pressure formatting in Scale template
2025-07-13 addedkPidDisabled to toggle switch and set machineState to initial switch state on boot
2025-07-18 Fix initial state of water tank sensor
2025-07-22 Implement scale fixes suggested by @scottcondie24
    * Stop brew via state machine when BLE scale connection is lost and
    brew-by-time is disabled
    * Allow negative weights after tare
    * Add Bluetooth icon to upright display template
    * Remove global scale-related variables and populate calibration factors
    via ParameterRegistry
2025-07-29 Add timer feature for BLE scales, improve memory management in AcaiaArduinoBLE library
2025-08-06 Added streaming function for parameters to regularly clear memory and reduce crashes Added defer to .js headers to reduce concurrent access requests to ESP32
2025-08-06 Set Dallas temperature sensor to asynchronous read
2025-09-01 Changed to to a css and js loader, added warning if page doesn't load, increased pid maxs, added blink parameters, improved pressure sensor response if not found, added force display update on long l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
2025-09-16 Reduced the size of some arrays to improve free heap space. Changed graphs to local time and added a warning about Steam LED interfering with USB console. Added 5s print of heap space, removed brew w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
2025-10-09 Added manual flush while backflush idle, fixed post brew timer when not fullscreen
2025-11-23 Changed relay pin assignments so they stay as default floating inputs until after parameters are loaded.
2025-11-26 Updated ESP32Async and added local/cdn override inside load-libs.js, default auto
2025-12-08 Removed timerAlarmWrite from onTimer, added check that timer is still operating
2025-12-10 test if scale initialised, changed scale descriptions and set the second calibration to only show with two load cell controllers
2025-12-30 Show a banner with a button when saved changes require a reboot
2025-12-30 Always show warning for hardware changes, add reboot flag for scale samples
2026-01-01 Fix standby mode issue when steam switch is set to toggle
    Add edge detection for steam toggle, only enter steam mode for rising
    edge. This prevents an issue where the state machine would immediately
    leave standby mode when the steam switch was active.
2026-02-26 Changed status LED to use user configurable delta. Added a counter to pressure sensor to limit DEBUG messages. Changed a few variables to uint8_t to reduce bytes used
2026-03-11 Fix PID tuning parameters with activated PonM in main.cpp
    with PonM activated setPIDTunings used the brew PID parameters for the normal PID parameter set
2026-10-19 Argenta SME firmware: encoder, SPI display bring-up, custom pin map
    Custom-board firmware baseline accumulated across bring-up sessions:
    - Duppa I2C rotary encoder (encoderHandler.h): init, event logging, and an
    RGB status LED driven by machine state. Web-configurable (fitted, address,
    RGB variant, status colors) via a new Encoder config section.
    - New kColor parameter type (Parameter.h, ParameterRegistry, Config.h), plus
    config-backfill so keys missing from a saved config.json get their
    registered default at boot instead of reading as zero.
    - SPI SSD1309 2.42" display path in main.cpp, sharing the SPI bus with the
    two MAX31865 RTD chip-selects. TSIC/Dallas removed (used a pin this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
2026-10-19 Web UI: dark mode, single navbar, encoder config + I2C address picker
    - Dark mode (dark-mode.css), toggled from the navbar, saved in the browser,
    and applied before first paint so there's no light flash on load.
    - Home/Settings/Hardware/System/About all moved into the one top navbar;
    removed the duplicate second row of tabs on the settings page.
    - Encoder config section with a native color-picker input for the new
    kColor parameters (app.js).
    - Encoder I2C address is a dropdown fed by a live bus scan (auto-scans when
    the Encoder section opens), shown in hex, instead of a decimal number box.
    - Supporting changes in load-libs.js, temp.js, about.html, system.html, and
    auto_compression.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
2026-10-19 Hold USB upload at 115200
    460800 fails on this board's CP2102/cable ("Unable to verify flash chip
    connection" right after the baud switch, alongside esptool's
    unsupported-crystal warning). 115200 uploads reliably.
2026-10-19 Boiler RTD: wire up the MAX31865 PT100 sensor (builds, not yet HW-tested)
    Brings the parked MAX31865 driver into the build as the boiler temperature
    sensor. The driver already matched the current TempSensor interface, so no
    interface port was needed - the work was integration:
    - Moved TempSensorMAX31865.{h,cpp} from argenta-wip/ into
    src/hardware/tempsensors/ so it compiles.
    - Switched it from software SPI to the shared hardware SPI bus (constructor
    now takes only the chip-select). It rides the same bus as the SPI display,
    each device picked by its own CS - software bit-banging the same pins the
    display drives in hardware would have been unreliable.
    - Hoisted SPI.begin() in main.cpp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
2026-10-27 Teensy pinout review: verified pin table, ERC fixes (phase 0)
    Phase 0 of the Teensy 4.1 + ESP32-S3 port. Extracted every Teensy pin
    assignment from the KiCad schematic as a netlist (pins matched to global
    labels by coordinate) and verified each against the real Teensy 4.1
    peripheral map, cross-checked against the Teensy core sources
    (PaulStoffregen/cores teensy4/pwm.c for the FlexPWM/QuadTimer table,
    PaulStoffregen/SPI for the LPSPI4 defaults).
    Findings resolved in the schematic:
    - No ESP32-S3 link pins existed. Added Serial1 on the free D0/D1 pair
    (D1 TX1 -> ESP32 RX, D0 RX1 <- ESP32 TX), 3.3V both ends.
    - Pump PWM had no default-off bias. The four ULN2003 outputs are held off
    at boot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
2026-10-27 Phase 1: Teensy 4.1 build skeleton with fail-safe boot and watchdog
    Adds the Teensy control firmware's scaffolding. It boots, proves the board
    is alive, holds every actuator in its safe state and feeds a hardware
    watchdog. It deliberately controls nothing yet - the handlers are ported
    in later phases.
    Build (platformio.ini):
    - New teensy41 env (platform = teensy, board = teensy41).
    - build_src_filter on the Teensy env is the running ledger of the port:
    only files actually ported are compiled, so the build cannot silently
    pull in ESP32-era code still sitting in src/.
    - ESP32-specific build_flags, lib_deps and extra_scripts moved out of the
    shared [env] block and down into esp32_usb, so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
2026-10-27 Phase 2a: actuator output layer and bench bring-up console
    First slice of the hardware layer: the four relay/valve outputs, plus the
    serial test mode firmware-plan.md calls for, so each channel can be
    verified with a meter before anything is plumbed or energized.
    outputs.{h,cpp} - wraps the existing upstream Relay/GPIOPin interfaces
    rather than replacing them (both port to Teensy unchanged). What it adds
    is a single choke point so energizing something is never a bare pin write
    buried in a handler:
    - Turning a channel ON is refused while a fault is latched. Turning OFF is
    never gated - a safety path must not be able to fail because of a safety
    check.
    - All four channels are HIGH_TRIGGER.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
2026-10-27 Fix: watchdog feed starved the USB interrupt, killing the serial console
    Found on real hardware during phase 2 bring-up. Symptom was a Teensy that
    looked completely dead over USB - no banner, no heartbeat, nothing - while
    actually running correctly the whole time.
    Cause: safetyWatchdogFeed() briefly masks interrupts around WDOG1's
    two-word service sequence, and the main loop runs free, so it was calling
    that several million times a second. The USB interrupt was starved badly
    enough that the CDC could never transmit. Adding any delay to the loop
    made it "work", which is what made this look like a phantom.
    Fixes:
    - Rate-limit the actual service to once per 100 ms. Feeding a 4 s watchdog
    a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
2026-10-27 Print the banner whenever a serial monitor attaches, not just at boot
    The board boots and starts running about 1.5 s after reset, but a serial
    monitor is opened seconds later - so the banner, the self-check result and
    the command list had all scrolled past before anyone could see them. The
    observed behaviour was: upload, open the monitor, get nothing but a bare
    "alive, uptime 42s" heartbeat, and have no way to tell whether the
    firmware was healthy or what commands existed.
    On Teensy, (bool)Serial reports whether the USB host has the port open, so
    a false->true transition is a monitor attaching. The loop now watches for
    that edge and re-prints the banner, the current uptime, the fault state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
2026-10-27 Pin the Teensy monitor port instead of relying on auto-detect
    The IDE's serial monitor showed nothing at all, even after the banner was
    made to re-print on connect. Cause: with no monitor_port set, PlatformIO
    auto-detects and takes the FIRST serial port it enumerates. On this bench
    that is a Prolific PL2303 adapter at /dev/ttyUSB0, which is not the
    Teensy - so the monitor was faithfully displaying a silent, unrelated
    device while the Teensy talked to nobody on /dev/ttyACM0.
    Pinned with monitor_port = hwgrep://16C0:0483, matching the Teensy by USB
    vendor:product. Chosen over hardcoding /dev/ttyACM0 so it still works
    after a replug or on a different machine, and still resolves correctly if
    ot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
2026-10-27 Record logic-analyzer verification of the Teensy output pins
    Checked the four actuator pins physically with the Kingst LA2016 on the
    bench machine, driving them from the phase 2a console. This is the
    difference between the firmware claiming a pin number and the pin
    actually moving, done while a swap still costs nothing.
    Test 1, each channel on for 2 s in turn: every command drove exactly the
    intended pin and no other, so nothing is swapped in either the firmware or
    the schematic. Only one channel was ever high, confirming the
    one-at-a-time interlock at the physical level instead of trusting the
    console's own status output. Hold times matched the commanded 2.000 s to
    within 3 ms, and there w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
2026-10-27 Phase 2b: both MAX31865 RTDs, with boiler-sensor safety
    Adds the two PT100 probes and the first real sensor safety. The existing
    TempSensorMAX31865 needed no reconciling - commit daa1def already wrote it
    against the current Timer-based TempSensor interface - so this is wiring it
    into the Teensy build and deciding what a bad reading means.
    tempHandler.{h,cpp}, new, following the xHandler convention:
    - Boiler probe (CS 15) is safety-critical. A MAX31865 fault flag, an
    implausible value (outside -20..200 C), a reading over a hard 140 C
    limit, or a reading that simply stops updating for 3 s all latch the
    machine safe. Running a 1500 W element on a temperature you cannot trust
    is how boi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
2026-10-27 Phase 2b: both MAX31865 RTDs, with boiler-sensor safety
    TempSensorMAX31865 needed no reconciling - commit c64cf1d already wrote it
    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
2026-10-27 RTD diagnostics: decode every fault bit, and report raw resistance
    Two bring-up aids, both earned during an actual RTD wiring fault where the
    first version of the fault decoding sent the diagnosis the wrong way.
    Decode every set fault bit instead of the first match. Fault 0x58 is
    "RTD below low threshold" PLUS both FORCE- open bits, and the original
    if/else chain reported only the threshold bit - true, but it points at the
    probe when the real fault is an incomplete current path. Both FORCE- bits
    together now produce an explicit hint to check the breakout's 2/3-wire
    jumper first, since on a 3-wire probe that jumper is what ties F- to RTD-.
    Add 'rtd', which reports the resistance each board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
2026-10-27 Tighten the RTD resistance classifier; 362 ohm is not "plausible"
    The first version of this band accepted anything from 80 to 400 ohm as a
    healthy PT100, so when a probe read 362 ohm during bring-up it was reported
    as plausible. It is not: a PT100 is 100 ohm at 0 C, ~110 at 25 C, 138 at
    100 C and ~175 at 200 C, so 362 ohm at room temperature is roughly 250 ohm
    of series resistance that does not belong in the circuit - the signature of
    a loose screw terminal or a strand barely touching.
    A diagnostic that endorses a faulty reading is worse than no diagnostic,
    because it sends the search in the wrong direction. Now:
    < 5 ohm open, no current path
    < 90 too low - partial short, or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
2026-10-27 RTD bring-up tools: SPI write test and raw register dump
    Two more diagnostics, both added while chasing a real RTD fault that is
    still open.
    testSpiWrites() - reads and writes fail independently, and only reads had
    ever been proven. If SDO/MISO works but SDI/MOSI does not, every register
    read returns believable data while every write is silently discarded, so
    the chip never gets VBIAS enabled and reports an open circuit that looks
    exactly like a disconnected probe. Writes a known pattern to the threshold
    registers (plain storage, no effect on measurement) and reads it back.
    Result on this board: writes are fine, which eliminated that whole class.
    dumpRegisters() - talks to the chip directl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
2026-10-27 Use the RTD boards in 4-wire mode, and fix the diagnostic that corrupted reads
    Switches the MAX31865 configuration from 3-wire to 4-wire, and fixes a bug
    in the register dump that was quietly poisoning every reading taken after
    it.
    Why 4-wire: 3-wire requires strapping the breakout's FORCE2 pin to FORCE+
    through its three-pad jumper, which means cutting a PCB trace. On these
    boards that conversion left FORCE2 at GND, and with FORCE2 grounded the
    chip simply cannot complete its current loop in 3-wire mode - it reported
    "FORCE- open" no matter what was attached. That single fact explains a long
    bring-up session in which the probe, the wiring and both boards were all
    repeatedly suspected and a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
2026-10-27 Fix init ordering: sensors were constructed after the self-check that tests them
    outputs::init() and temps::init() ran AFTER runBootSelfCheck(), so the
    boiler RTD was still a null pointer when the check queried it. The check
    therefore reported the sensor unavailable and latched the machine safe on
    every single boot - including with a perfectly good probe attached and
    reading correctly through the console a second later.
    The comment above the old call site even said "sensors before the
    self-check, which depends on them", while the call sat below it. Moved
    both inits above the check, where the comment always claimed they were.
    This was the last thing standing between a working probe and a wo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
2026-10-27 Give the group RTD the same diagnostics as the boiler
    The group sensor only printed its resistance, which cannot tell "probe
    open" from "chip not responding" - both read zero. Adding the SPI write
    test and register dump to it immediately separated the two: every register
    read back 0x00, including ones that cannot legitimately be zero, while the
    boiler board was reading correctly on the same shared bus at the same
    moment.
    That isolated the fault to the only wires not shared between the two
    boards - chip-select and power - because CLK, SDI and SDO were proven good
    by the boiler working through them. The group board's CS was on pin 15
    instead of 16, so it was never being selected. Moving it fi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
2026-10-27 Fix a real safety hole: a failing sensor looked healthy, and the heater ran
    Found by pulling a probe lead from a RUNNING sensor - a case never tested
    before, since every previous test used a sensor that was already broken at
    boot. With the lead out and the chip reporting an open circuit four times a
    second, 'on heater' was ACCEPTED.
    Three compounding causes:
    1. The sensor base class needs ten consecutive failures before hasError()
    goes true - four seconds of blindness at the 400 ms update rate.
    2. Worse, getCurrentTemperature() keeps returning the LAST GOOD value while
    a sensor is failing. The handler saw a plausible number and marked the
    sensor healthy.
    3. Worst, the handler's st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
2026-10-27 Phase 2c: DM60 flow sensor - pulse counting, volume and rate
    Net-new code. CleverCoffee has no flow support anywhere (checked this fork
    and upstream master and develop); its only shot-stop methods are by time
    and by weight. So there is nothing to port and nothing to cross-reference
    against - this is written from the sensor's behaviour outwards, which also
    makes it the highest-risk piece of the port.
    flowHandler.{h,cpp}:
    - Interrupt-driven pulse counting on pin 10. The ISR does the least work
    that is correct: a reject test and two counters, no arithmetic, no
    floating point, no logging. Volume and rate are derived in the main loop
    where taking time is harmless.
    - Glitch rejection at 200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
2026-10-27 Phase 2d: I2C bus and DuPPa encoder working
    i2cHandler.{h,cpp} - shared bus with recovery, diagnostics and a scanner.
    encoderHandler.{h,cpp} - DuPPa i2cEncoder V2 ported from the ESP32 build.
    Two bugs here were mine and both cost hours of someone else's bench time.
    1. THE SCANNER SKIPPED THE DEVICE. It probed only 0x08-0x77, because the
    I2C spec reserves the ends. That is textbook-correct and it hid a
    working encoder: a DuPPa with no address jumpers soldered answers at
    0x04, inside the reserved range. Worse, the very first scan DID report a
    hit near there and I dismissed it as an artifact, then narrowed the range
    to exclude exactly where the device lived. The scanner now swe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
2026-10-27 Fix the ESP32 reference build, broken by the encoder moving to the Teensy
    Porting encoderHandler.{h,cpp} to the Teensy overwrote the file the ESP32
    build still depended on, and I committed that without the esp32_usb build
    passing - the commit chain continued past a FAILED build. Both envs build
    again now, and the fix is the architecturally correct one rather than a
    patch.
    The encoder is Teensy-owned by design: it carries the control gestures AND
    the machine-status RGB LED, both of which belong to the side that owns the
    machine state, so an ESP32 or display failure can never take the encoder
    with it. The head therefore should not have been driving it at all.
    Removed from src-esp32s3/main.cpp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
2026-10-27 Correct the encoder address documentation: 0x04 is configured, not default
    The previous commit asserted throughout - in code comments, in the
    scanner's output and in the commit message - that this encoder sits at
    0x04 because "no address jumpers are soldered". That was an assumption I
    made and never checked against DuPPa's addressing documentation or against
    the board itself.
    It is wrong. DuPPa's address chart lists 0x00-0x7F as selectable by the
    A0-A6 jumpers, and this unit has A2 soldered, which gives exactly
    0b0000100 = 0x04. The address is deliberately configured. The suggestion
    that it should be re-soldered to 0x66 to "move it off a factory default"
    was therefore unnecessary work based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
2026-10-27 Encoder address: 0x04 is the DuPPa factory default (A2 fitted at manufacture)
    Third pass at the same comment, so stating it plainly: the board ships with
    the A2 jumper fitted, giving 0x04. I first wrote that no jumpers were
    soldered (wrong mechanism), then that it was deliberately configured (wrong
    implication). It is simply the factory default.
    The scanner lesson stands and is now stated correctly: the DuPPa's default
    address sits inside the range the I2C spec reserves, so a by-the-book
    scanner misses a brand-new encoder straight out of the box.
2026-10-31 ESP32-S3 display head: build env, LovyanGFX config, bring-up screen
    First code for the display head. It is a terminal, not a controller: WiFi,
    web UI and the colour touch LCD only, no actuators and no safety. If this
    board crashes or is never fitted, the Teensy runs the machine and finishes
    shots exactly as normal.
    Hardware is the LCDwiki / Hosyond 4.0" ESP32-S3 Display, and the pin map
    here is taken from that board's page rather than assumed. Worth recording
    that it differs from what the brief originally planned - that described a
    3.5" ST77922 over QSPI. The real board is:
    LCD ST7796S, 320x480 IPS, 4-line SPI
    CS 10, DC 46, SCK 12, MOSI 11, MISO 13, backlight 45
    RESE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
2026-10-31 ESP32-S3 display head working: landscape, correct colours, touch mapped
    Verified on the real panel: 480x320 landscape, text correctly laid out,
    colour bars in the right order, and touch tracking under the finger.
    Changes from the first bring-up:
    - Default rotation is 1 (landscape 480x320). The panel is natively 320x480
    portrait, so landscape needs an explicit rotation.
    - The bring-up screen is laid out from lcd.width()/height() and from derived
    vertical offsets rather than hand-placed numbers, so nothing collides when
    the rotation changes the available height. The first version hard-coded
    positions written for portrait and the caption overlapped the colour bars
    once it was landsca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
2026-10-31 Phase 2e: Teensy <-> ESP32-S3 link, with live telemetry on the panel
    The two boards are now one machine. Teensy TX1/RX1 (D1/D0) to the head's
    UART0 (IO44/IO43) at 115200.
    lib/LinkProtocol/linkProtocol.h is SHARED by both builds, so the wire
    format has one definition and the two firmwares cannot drift apart.
    Frame format is NMEA-like and deliberately ASCII:
    $<type>:<key>=<value>,...*<xor-checksum>\n
    Readable in a plain terminal and typeable by hand, which matters: a binary
    protocol needs a working decoder before you can see anything at all, and
    this session has shown repeatedly how much that costs. The price is a few
    bytes at 5 Hz on a private wire. The parser resynchronises on '$', s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
2026-10-31 Groundwork for over-the-link firmware updates: the safety half, first
    Deliberately NOT a flasher. This is the gating, the mode entry, and the
    guarantee that a machine being updated is provably not controlling
    anything. FlasherX drops into runLoop() later.
    The order matters. Retrofitting safety onto a working flasher means testing
    it by nearly flashing a live machine; building the gate first means the
    dangerous path can be exercised now, while nothing downstream can write
    flash at all.
    THE PROBLEM IT SOLVES: the runtime watchdog cannot be switched off - WDOG1's
    enable bit is sticky until reset, deliberately, so firmware can never
    disable its own safety net. But flash erase/write blocks for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
2026-10-31 Startup sound on the display head's speaker
    The LCDwiki 4.0" board carries an ES8311 codec, an FM8002E class-D amp and
    a 2-pin speaker socket, so a startup chime costs nothing but code. John's
    startup.mp3 is converted to raw 16-bit mono PCM at 44.1 kHz and linked into
    the firmware image via board_build.embed_files, so one upload stays one
    upload - a separate LittleFS image would be a second command that is easy
    to forget, leaving the sound silently missing.
    Hand-rolled ES8311 driver rather than a library. Every ES8311 Arduino
    library drives the codec through Wire on I2C port 0, but LovyanGFX has
    already claimed port 0 for the touch panel using the IDF driver directly,
    and the codec sits on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
2026-10-31 Audio: playback is on IO8, not IO6, and set the volume by ear
    Two findings from bringing the speaker up on real hardware, both of which
    cost time because every diagnostic looked healthy while nothing came out.
    PLAYBACK DATA GOES OUT ON IO8. The LCDwiki page calls IO6 the "bit output
    data signal" and IO8 the "bit input data signal" without saying whose
    output and whose input. Read from the ESP32's side - the obvious reading
    for a board pinout - playback belongs on IO6, and that produces exact
    silence with a correctly configured codec and correct clocks. The page is
    naming the pins from the CODEC's side, the way codec datasheets label
    DSDIN and ASDOUT: IO8 is the codec's input and takes playb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
2026-11-01 Brew switch on Teensy pin 24: debounced, sense-selectable, verified
    Phase 2 bring-up for the hardwired panel brew switch. Reads and reports
    only - nothing acts on it until the brew state machine arrives in phase 3.
    Built on upstream's own Switch/IOSwitch classes rather than a fresh
    implementation, so debounce and short/long-press behaviour match upstream
    exactly and brewHandler.h can be ported later without reworking what it
    reads. IOSwitch and Logger both already compile for Teensy, so this needed
    no new hardware abstraction.
    READ THE SCHEMATIC FIRST (relays.kicad_sch): BPSW_SW1 is a 3-pin header -
    signal, +3.3 V, GND - with R9 (47 k) pulling the signal and JP2, a 3-pad
    solder jumper, sel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
2026-11-01 HX711 load cell handler: non-blocking start, honest health reporting
    NOT YET VERIFIED ON HARDWARE - the load cell is not wired up at the time
    of writing. Both builds compile; nothing here has read a real gram.
    Uses upstream's Scale and HX711Scale unchanged for the hardware layer, so
    the reading path and dual-cell support stay cross-referenceable. Named
    weightHandler rather than scaleHandler because upstream's name is taken:
    src/scaleHandler.h is the ESP32-era header still included by brewHandler.h
    and the frozen reference build. It could not be reused anyway - it reaches
    into config, the display and the brew state machine, none of them ported.
    It can take the upstream name when the head spl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
2026-11-01 HX711: verified on hardware, with a presence check the library cannot do
    The load cell reads. DOUT goes low 76 ms after the clock is released, the
    stabilise-and-tare sequence completes, a firm press swings it about 15,000
    counts and it returns to a noise floor of roughly plus or minus 80 counts
    after a tare. Readings stay fresh and healthy throughout.
    Added a direct DOUT presence probe, used by init() and exposed as
    'scalediag', because THE LIBRARY CANNOT ANSWER THIS QUESTION. Its
    getSignalTimeoutFlag() looks like exactly the right check and is useless
    here: startMultiple() resets the timestamp the timeout is measured from on
    every call, and this code calls it every loop pass, so the timeou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
2026-11-01 Scale: electronics verified, calibration blocked on mechanical mounting
    The HX711 and the load cell read correctly and quietly. Calibration is
    NOT done, and cannot be until the cell is mounted properly - the numbers
    below are why, recorded so this is not re-litigated from memory later.
    Measured, using 18.1 g and 74.3 g references:
    empty -6.63 (provisional g units), spread 0.03 g when undisturbed
    18.1 g 28.26 above empty -> 865 counts/gram
    74.3 g 68.21 above empty -> 509 counts/gram
    74.3 g again, replaced -> 55.33 vs 61.59 for the SAME mass
    A 70% disagreement between the two references cannot be load cell
    nonlinearity - these are linear to a fraction of a p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
2026-11-01 Show the brew weight on the LCD, labelled honestly
    Weight now crosses the link and is drawn large on the machine screen,
    since during a shot it is the number being watched.
    Three fields rather than one: wt, wok, and wcal. That last one says
    whether the value is grams or raw ADC counts, and it is sent explicitly
    rather than inferred at the far end. The head needs to KNOW, because
    printing raw counts next to a "g" would invite someone to trust a dose
    that is nonsense - and the scale is uncalibrated right now and will stay
    that way until the load cell is rigidly mounted. So an uncalibrated
    reading is drawn in orange with the unit spelled "raw", and only a
    genuinely calibrated one gets yellow a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
2026-11-01 Fix the weight unit label sitting on top of the digits
    The unit was drawn at a fixed column chosen for a six-character number.
    Raw ADC counts run to eight ("-11422.0"), so "raw" landed on the last
    digits. The label is now placed from getCursorX() after the number is
    drawn, which cannot be wrong whatever the value, and the rest of the row
    is wiped with fillRect - overwriting with a background colour only covers
    where glyphs are actually drawn, so a shorter number would otherwise leave
    the previous frame's digits sticking out.
    Raw counts also print whole now. A tenth of an ADC count is not a real
    quantity and the decimal was only eating width a five-digit raw value
    needs.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
2026-11-01 Weight field: fixed width, so the unit cannot collide with the number
    Third attempt at this, and the first one that is deterministic. The first
    reserved six characters and an eight-character raw count overran it, so
    "raw" landed on the digits. The second positioned the unit from
    getCursorX(), which moves as the value changes width, and it still came
    out wrong.
    Both were trying to place a label relative to something variable. The
    number is now a fixed-width right-aligned field - eight characters, the
    worst case, since raw counts are signed 24-bit and "-8388608" is as wide
    as it gets - so it always occupies exactly the same pixels and the unit
    sits at a constant x computed from that width. Dr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
2026-11-01 Weight readout: pin the number left, unit adjacent, clear before drawing
    Fourth attempt, and the three wrong turns are recorded in the source
    because each looked reasonable:
    1. Unit at a fixed column sized for six characters. An eight-character
    raw count overran it and "raw" sat on top of the digits.
    2. Unit positioned from getCursorX() with a fillRect tidy-up afterwards.
    The tidy-up clipped the label.
    3. Fixed-width RIGHT-aligned number. Nothing overlapped, but a short
    value floated off to the right and dragged the unit with it.
    The requirement is number pinned left, unit adjacent, and no leftovers
    from a wider previous value. That needs the row cleared BEFORE drawing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
2026-11-01 Weight readout at size 3, between boiler and the small row
    At size 4 it matched the boiler temperature and competed with it, and the
    boiler is the number that matters when the machine is idle. At size 2 it
    would vanish into the flow/volume/encoder row, and brew weight matters
    more than any of those once a shot is running. Three sits between them.
    Also added a one-shot full-height wipe of that row. The per-frame clear is
    sized to the current font, so shrinking the text would otherwise leave the
    taller glyphs' top rows behind after a reflash.
2026-11-01 Refresh the averaging window before taking a calibration point
    Found by actually reading what upstream CleverCoffee does, after John
    asked whether it differs - it does, and I was missing a real step.
    Before taking its calibration reading, upstream calls the library's
    refreshDataSet(), which resets the sample index and refills every slot
    with a NEW conversion. Without it the calibration is computed from a
    rolling average that still contains pre-load samples. My first attempt
    did exactly that, which is part of why the resulting factor was junk.
    Not done by calling refreshDataSet(), which blocks until the set refills -
    seconds at ~10 conversions per second - and would trip the 4 second
    watchd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
2026-11-01 Read BOTH load cells, each with its own signed factor - calibration works
    This is the actual fix for the "load cell behaves badly" problem, and it
    was never the load cell or the mounting bracket. Two causes, found after
    John said he had two cells under one shared 3D-printed plate and asked
    whether CleverCoffee's HX711 code did something different.
    CAUSE 1: ONLY ONE CELL WAS BEING READ. A plate spanning two cells divides
    the load between them by position, so one cell measures an unknown
    fraction of the weight. That looks exactly like a faulty cell - rock
    steady when empty, irreproducible the moment anything is placed on it:
    same 411.7 g mass replaced 61.59 then 55.33, 10% apart
    18.1 g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
2026-11-01 Scale: detect a saturated cell, and keep the calibration across reboots
    SATURATION DETECTION. Moving the 411.7 g reference off to one side drove
    cell 2 to -8,231,000 counts - 98% of the HX711's 24-bit full scale, hard
    against the stop - and the handler reported the resulting -5269 g as
    "healthy". That is the exact failure mode this file guards against
    everywhere else: a number that is not a measurement, presented as one.
    Each cell is now checked against 90% of full scale on every conversion,
    per-cell rather than as a sanity check on the final number, because the
    total is a sum and one pinned cell corrupts it. A saturated cell makes
    healthy() false and prints why.
    WHY IT SATURATED, which is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
2026-11-01 Pump as variable-speed PWM, and out of the relay channel list entirely
    The pump is a brushed DC motor on a DRV8871, not a relay. Proportional
    speed is the entire point of it - pre-infusion, pressure ramps, declining
    profiles - and an on/off pump can do none of that.
    John has decided this machine will only ever run a DC pump, so the board's
    "Pmode" jumper (pin 9 either to ULN2003 channel 2 as an on/off pump relay,
    or straight to the driver) is being removed and pin 9 is PWM-only. The
    pump is therefore gone from outputs::Channel altogether rather than left
    there as a mode: two code paths must never both drive pin 9, and the
    surest guarantee is that only one of them knows the pin exists. ULN
    c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
2026-11-01 Record the broken pump PWM net, and why the pinout review missed it
    The pump path had a global label at each end with a DIFFERENT name:
    PUMP_PWM on the Teensy D9 side and PMP_PWM at the PUMP_PWM1 header. Global
    labels connect by exact name, so those were two separate nets and D9 never
    reached the driver header - the pump would not have run at all on a
    fabricated board. The 10k pull-down was stranded on the header-side net
    too, leaving the Teensy pin with no default-off bias.
    John renamed the header-end label. Verified in the saved file: PUMP_PWM
    appears twice, PMP_PWM is gone, and R19 now pulls the whole net including
    D9 low at reset.
    Recorded in the review document along with why that rev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
2026-11-02 Verify the pump PWM on the wire: duty tracks to 0.4% across the range
    Measured with the DRV8871 connected and the LA2016 on Teensy D9 (CH3) at
    10 MHz sampling:
    commanded 10% -> 10.07% 20.14 kHz
    20% -> 19.96% 19.96 kHz
    35% -> 35.10% 19.84 kHz
    50% -> 49.61% 19.84 kHz
    75% -> 75.41% 19.67 kHz
    100% -> static HIGH, no switching
    Every level within about 0.4% of commanded, and 100% correctly collapses to
    a continuous high rather than a 99.98% duty. Frequency sits 0-2% under
    20 kHz, which is FlexPWM prescaler quantisation and of no consequence.
    This settles a question the ear could not: John heard only two dis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
2026-11-02 R10 is the wrong value: 47k pull-up on a sensor needing 1.2k-4.7k
    The flow sensor never worked, and it was never the sensor, the wiring, the
    pump or the firmware.
    The DM60's datasheet requires a 1.2k-4.7k pull-up on its open-collector
    signal pin. R10 on this board is 47k, 10 to 40 times too weak, and the
    Teensy's ~22k internal pull-up standing in for it on the breadboard is no
    better. The sensor's output transistor pulls the line down and the weak
    pull-up cannot bring it back up between pulses, so there is no high state
    to fall from and the falling-edge interrupt almost never fires.
    Measured: 4 pulses in 30 seconds with water flowing at a good rate,
    against an expected ~40,000 per litre. A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
2026-11-02 Flow: use the DM60's datasheet K-factor, and record its mounting rules
    John found the datasheet (Digmesa Nano DM60, 93N-6211-1100x) and it
    settles several things that had been guesswork.
    K-factor is 49,162 pulses/litre, quoted to +/-2.0% across a linear range
    of 0.05-3.0 l/min. The previous 42,000 was the middle of the range across
    DM60 variants - a guess, and 15% low for this part. That is a real figure,
    good enough to use directly, so the status line no longer calls it
    "DEFAULT - not yet calibrated"; saying so would invite distrust of a
    number that is fine. A gravimetric calibration would still beat it and
    should happen once the machine can dispense onto a working scale.
    The datasheet al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
2026-11-02 Add a megahertz-rate sampler for the flow pin
    The polled watch samples from the main loop at a few kHz at best, so "no
    level changes" from it proves nothing - it cannot see a short pulse. This
    blocks for a bounded 300 ms and samples as fast as the core will go,
    which measured at 42.75 MHz, 12.8 million samples in the window.
    It answers the question the pulse counter alone cannot. Transitions with
    no interrupts would mean the interrupt is broken; no transitions means the
    signal genuinely is not moving and the fault is outside the firmware. It
    also reports the fraction of the window spent low, which separates a line
    held hard at ground from one pulsing at a very short duty.
    Blocking is delib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
2026-11-02 Flow sensor works: 10,561 pulses, 214.8 ml in 20 s. It was direction.
    The DM60 was plumbed backwards. John suggested that early on and I talked
    him out of it, saying a reversed turbine still spins and would give some
    pulses. That is true of a plain paddle-wheel and false here: the DM60
    drives its turbine with a jet through a 1.1 mm nozzle, so backwards the
    jet geometry does not turn the wheel at all and water passes straight
    through.
    Backwards: 4 pulses in 30 seconds with water flowing well.
    Correct: 10,561 pulses in 20 seconds, 214.8 ml, 10.7 ml/s.
    The diagnostic signature is worth remembering, and is recorded in the
    header: a BACKWARDS sensor pulls the output low and STAYS low, because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
2026-11-02 Audit every pin whose firmware depends on a pull resistor
    John asked whether anywhere the code relies on an internal pull-up ought to
    have an external one. The answer turned out more specific than yes: the
    board already has external pulls nearly everywhere, and two of them are
    just the wrong value.
    SDA/SCL R7, R8 4k7 correct for I2C
    ENC_INT R13 10k fine, open-drain on a short on-board trace
    WATER probe R14 10k reasonable
    FLOW R10 47k WRONG - datasheet wants 4k7
    BREW_SW R9 47k weak for a long panel lead
    HX711 DAT none - not needed
    The HX711 is a real exception worth recording so nobody "fixes" it: DOUT is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
2026-11-02 Record the revised brew switch block: 10k pull-down, cap on the signal
    John deleted JP2, changed R9 to 10k, and moved C5 onto the BREW_SW net.
    Final: R9 and C5 both BREW_SW to GND, switch between connector pins 1 and
    2, active high.
    Three improvements over the original, the first being the one that
    matters: SolderJumper_3_Open ships with no pads bridged, so a missed build
    step left pin 24 with no pull at all - a floating input on the signal that
    starts a brew. Hard-wiring removes a step whose omission is dangerous
    rather than merely wrong.
    Pull-down also fails safe on the likelier cable fault. The line idles low
    and the switch pulls it high, so a lead chafing against grounded chassis
    metal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
2026-11-02 Push UI changes to the panel immediately instead of waiting for the tick
    John reported the encoder feeling slow on the display. Two causes, both
    mine.
    First, the encoder was not on the display at all. When pump speed was
    added to telemetry it replaced the ENCODER field on screen and I did not
    flag the swap. It is back now as a fourth column beside PUMP.
    Second, the real latency, and it is the code rather than the link: 200 ms
    of telemetry period plus the head's flat 250 ms redraw timer is 225 ms of
    lag on average and 450 ms at worst. Fine for a boiler temperature, which
    moves slowly. Hopeless for a knob - turning it and waiting half a second
    for the screen to agree feels like a fault.
    The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
2026-11-02 Phase 3 stage 1: boiler PID with every interlock proven, output still gated
    The PID runs and computes duty; the heater cannot energise without
    deliberate enabling plus six other gates agreeing. Done in this order on
    purpose - every interlock is now proven with no element connected, which
    is the only sensible sequence for the one actuator that can destroy a
    boiler.
    Structure is upstream CleverCoffee's, unchanged: time-proportioning with a
    1000 ms window and a 10 ms tick giving 100 steps, PID output scaled 0-1000
    so the ISR compares it straight against its tick counter. The ESP32
    hardware timer becomes an IntervalTimer and nothing else about the scheme
    moves. Tunings are upstream's defaults (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
2026-11-02 Phase 3 stage 2: heater drive verified through the ULN2003
    The chain from PID to ULN output is proven, with no mains, no SSR and no
    element - only a wire from ULN O1 to Teensy pin 14.
    The ULN output is open collector, so with nothing attached it floats when
    off and an analyser reads noise. Rather than skip the chip, the Teensy
    monitors it: pin 14 as INPUT_PULLUP supplies the load that makes floating
    read as a clean high, and the firmware checks the output is the inverse of
    what it drove. No external components.
    Measured, PID forced to known duties by running it proportional-only:
    asked 100.00% -> 100.00% at the ULN output, 0 of 400 ticks mismatched
    asked 49.92% -> 50.00%,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
2026-11-02 README: explain why this fork exists, keep upstream's content below
    The README was still upstream's verbatim, which made the repo look like a
    plain mirror and left the obvious question unanswered - why two
    microcontrollers for an espresso machine.
    Now it leads with this fork: why a Teensy, why the split, how the work is
    divided between the two processors, the safety stance, current status, and
    how to build the three environments. The "why" section is deliberately
    honest that a single ESP32 is the right answer for most builds and that
    this is overkill for a straightforward PID retrofit - it only stops being
    overkill once variable speed pump control, brew by weight and autofill are
    added, and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
2026-11-03 Two-page espresso UI on the display head, with real fonts
    The panel was a bring-up readout: built-in 5x7 bitmap font scaled up, a
    flat list of values, and a touch handler that printed coordinates. It now
    looks like a machine.
    MAIN PAGE: boiler temperature in a seven-segment face (LovyanGFX Font7)
    with the target beside it, group temperature, a heater duty bar, a row of
    shot values - weight, flow with cumulative volume, pump - and a coloured
    status strip reading READY, HEATING, HEATER OFF or the fault name.
    SETUP PAGE, reached by the gear in the header: setpoint in 0.5 C steps,
    heater on/off, tare, zero volume, clear fault, brightness, back.
    Proper fonts throughout rather than the scaled b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
2026-11-03 Keep the two resets separate, and write down why
    The display must never be able to reset the controller. The ESP32 runs
    WiFi, a web server and MQTT - the parts most likely to crash, hang or need
    rebooting - so tying its reset to the Teensy would mean a wedged WiFi
    stack, an OTA update, or somebody pressing the reset button on the back of
    the display abandons a shot mid pull and drops the heater. A display stuck
    in a crash loop would become a machine stuck in a reboot loop.
    The reverse is not needed either: the display holds no state worth
    preserving, and it already handles the controller vanishing and returning,
    which every Teensy reflash exercises.
    What is added instead is one way and adv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
2026-11-03 Play the startup sound when the controller restarts, not just the head
    A machine restarting is worth noticing from across the room, and it was
    only audible when the display booted - a Teensy reboot was silent. The
    head already detects a controller restart from the Hello frame, so it now
    plays the chime there too.
    With one guard that matters: a cold start boots BOTH boards, so the
    Teensy's first Hello arrives a few seconds after the head has already
    played the sound at its own boot, which would chime twice for a single
    power-up. A Hello inside the first 20 seconds is therefore treated as part
    of the same power-up and ignored. Past that, a Hello means the controller
    alone restarted, which is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
2026-11-03 Make the over-temperature cutoff testable, and test it
    It was one of two interlocks that had never been proven, for the obvious
    reason: a bench boiler cannot be driven to 140 C, so the cutoff had never
    fired and nobody had seen the path work.
    The limit can now be LOWERED at runtime, which tests exactly the same code
    by moving the threshold down to meet the temperature instead of the other
    way round.
    It can never be RAISED above the compile-time kBoilerOverTempC. A settable
    safety limit that can be moved upward is not a safety limit, so
    setOverTempLimitC() refuses outright and the ceiling stays a constant that
    nothing at runtime, in a config file, or on the display can reach. Not
    persisted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
2026-11-03 Fix the setup page being unreachable: display::loop() was never called
    The gear did nothing and no touch registered at all. Not a hit box, not a
    mapping problem - display::loop(), which polls the touch panel, was never
    invoked from the main loop. Every handler and hit box in display.cpp was
    dead code: the buttons were drawn and could not be pressed.
    Nothing reported an error because nothing was wrong. The code was correct
    and simply never ran, which is the failure mode a clean build cannot
    catch. Logging the touch coordinates settled it in one pass - no
    coordinates at all meant the poll was missing, whereas coordinates that
    missed every box would have meant the opposite fix.
    That log is ke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
2026-11-03 Setup page: smaller button text, volume control, and spacing fixes
    CLR FAULT overflowed its button and is now CLEAR. Worth recording how
    that survived a round: the first attempt patched it with a plain
    str.replace and no assertion, matched nothing, and was reported as fixed.
    Every replacement in this pass asserts, which immediately caught a stale
    search string instead of silently doing nothing.
    Button labels drop to FreeSansBold9pt7b. They are read once to learn the
    layout and hit by position after that, so they do not need to compete with
    the numbers.
    The brightness buttons were touching the BRIGHTNESS caption. Captions now
    sit at y=178 and their buttons start at y=196, which clears the c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
2026-11-03 Brew sequence, ported from upstream's brewHandler, with encoder profiles
    PORTED, not invented. The first version of this was written without
    reading upstream's brew() first, which was the wrong order and produced
    gratuitous differences. Reworked to follow it:
    state names match upstream's BrewState - Idle, Preinfusion,
    PreinfusionPause, Running, Finished. An earlier draft called the pause
    "Soak", which was an invention that made cross-referencing harder for no
    gain.
    the BREW SWITCH drives it, as upstream does: a press starts a shot, the
    switch returning to idle aborts from any state, and a shot runs once per
    press rather than restarting under a held switch (upstream's
    brewSw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
2026-11-07 Manual flush and backflush, ported from upstream's brewHandler
    Ports upstream's manualFlush() and backflush() into shotHandler, which
    required also porting upstream's BrewSwitchState gesture machine: one
    switch has to mean three things, so it has to be read as a gesture
    rather than a level.
    Consequence, and it is user-visible: on a momentary switch a shot now
    starts on RELEASE, not on contact. The firmware cannot tell a press from
    a hold without waiting to find out, so press-to-start and hold-to-flush
    cannot coexist. Upstream resolves this by waiting; so does this. A toggle
    switch keeps level behaviour and, as upstream, has no flush gesture at
    all, because IOSwitch::longPressDetected() retu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
2026-11-07 Automated cooling flush, computed from the group probe
    Net-new, not a port, and that was checked rather than assumed: git grep
    across upstream/master and upstream/develop finds no cooling flush, no
    pre-brew flush and no idle-time flush. Upstream's only flush concepts
    are manualFlush and backflush, both already ported. thermal-management.md
    section 6 calls this one the prize.
    On a heat exchanger machine the water in the exchanger and the line to
    the group creeps towards boiler temperature while idle, around 123 C, so
    the first water through the puck is far too hot. Elsewhere the fix is
    folklore - flush "a few seconds". With a probe on the outlet line it can
    be computed. At home it matters mo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
2026-11-07 Config across the link: the head is master, the Teensy caches
    First half of the web UI work, and it closes the question left open in
    TEENSY-PORT-BRIEF.md section 4. Decision agreed with John and recorded as
    brief 9.6: the ESP32 head holds the persistent master configuration, as
    upstream does, and the Teensy keeps a validated EEPROM cache so it boots
    and runs correctly with the head unplugged.
    Upstream already contains the seam this uses. ParameterRegistry's
    addNumericConfigParam and siblings write the JSON config store, which is
    persisted, and ALSO mirror the value into an optional globalVar pointer
    that the control code reads. So upstream's store is already the master
    and the globals are a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
2026-11-07 Prove the config path over the real link, and fix a truncating console
    The previous commit tested the receive path through the Teensy's own
    console because the head's USB was not attached. With it plugged in, the
    whole round trip is now exercised: head builds a Config frame, Teensy
    parses it, routes it through the owning validating setter, persists it and
    acks, head prints the ack naming the key.
    brew.pre_infusion.time 3.7 ok became 3700 ms - scale right on the wire
    brew.by_time.target_time 900 REFUSED - the 180 s clamp held over the link
    cooling_flush.target_temp 88 ok
    mqtt.topic coffee/machine notmine - ignored, correctly not an error
    ...rtd_reference 430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
2026-11-07 Web server and WiFi on the display head, with setup sub-pages
    WiFi, LittleFS and the web server on the ESP32-S3, ported from upstream's
    wiFiSetup() and embeddedWebserver.h with the same library versions pinned.
    Verified live: joined a network, served the front end, and answered the
    JSON API from Teensy telemetry over the link.
    WiFi uses WiFiManager exactly as upstream does, and the reason that
    matters is the captive portal: when no saved network joins, the head
    raises its own AP and the OWNER types their credentials into a page it
    serves. Credentials go from the person straight into the ESP32's flash -
    never into a config file, a commit, or anyone else's hands. Any simpler
    scheme that puts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
2026-11-07 Fix the setup page's bottom row, and WiFi dropping the web server
    Two faults John reported from actually using it.
    SETUP PAGE BOTTOM WAS A JUMBLE, and the cause was mine. I added a
    "SETTINGS" caption at y=232 without checking what was already there: the
    brightness and volume buttons occupy 196..242, so the caption was drawn
    straight on top of them. Removed - the row has 52 px between those
    buttons and the footer rule at 294, which is room for a button row OR a
    caption, not both. The buttons are labelled WIFI and BACK and need no
    heading. Row refitted to 248..290 so it collides with neither.
    This is the third time I have adjusted this row by reasoning about it
    instead of reading the coordin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
2026-11-07 Setup becomes a menu of sub-pages, not one crowded screen
    John asked for sub-pages early on, and I built the mechanism and then
    kept cramming controls onto the single setup page anyway. The result
    looked exactly as bad as that sounds. This actually uses it.
    SETUP is now three large tiles and nothing else:
    BREW setpoint +/-, HEAT, TARE, ZERO VOL, CLEAR, live boiler status
    DISPLAY brightness and volume
    WIFI status, SET UP WIFI, FORGET
    Each page carries few enough controls to be laid out with room around
    them, so the buttons grew: setpoint +/- from 60x50 to 70x60, brightness
    and volume from 56x46 to 80x64. BACK sits in the same place on every
    page so it is muscle memory rat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
2026-11-07 Head build picks up upstream's config machinery
    Groundwork for the web UI's settings pages. Adds Parameter.cpp to the
    esp32s3 build and puts src/ on its include path, so the head can use
    upstream's Config, ConfigDef and Parameter unchanged. Builds clean.
    These carry across as-is because their only hardware dependencies turn
    out to be nominal: Relay.h merely forward-declares GPIOPin, and Switch.h
    is a pure interface. Both are needed only for enum constants in the
    config defaults.
    ParameterRegistry.cpp is deliberately excluded. Of its 1440 lines, all
    but about 25 are one initialize() that registers ~100 parameters bound
    to ESP32-era globals - steamON, machineState, the OLED, the status LEDs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
2026-11-07 Head parameter registry: upstream's machinery, this machine's list
    Defines the three generic pieces of ParameterRegistry that its .cpp would
    normally provide - the singleton, getParameterById() and
    syncGlobalVariables(), all copied unchanged - plus a head-specific
    initialize(). The inline add*ConfigParam helpers in the header are reused
    as they are. So the divergence from upstream is one function, not a fork
    of a 1440-line file.
    That one function has to differ: upstream's initialize() binds nearly
    every entry to an ESP32-era global this board does not have - steamON,
    machineState, the OLED, the status LEDs.
    THE SEAM, which is the point of the exercise. Upstream's helpers write
    the JSON con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
2026-11-07 Web UI settings work end to end, and the link stops losing frames
    Instantiates Config on the head, initialises the registry, and adds
    upstream's /parameters GET and POST. The browser can now read and change
    settings and the controller applies them.
    The endpoints keep upstream's path and JSON shape because
    frontend/js/app.js is upstream's and drives everything off them.
    Diverging there would mean forking the largest single chunk of their
    code. GET streams its response rather than building a String: the
    registry is small today but this is the reply that grows with every
    setting, and a large String on a board running WiFi and a framebuffer
    works right up until it does not.
    The head pushes its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
2026-11-07 README: adopt the rewritten version, with five factual corrections
    Takes John's README_new.md, which reads far better than what it
    replaces, and fixes the things in it that are not true of this code.
    Corrected against the source rather than from memory:
    - "Dual PT100 RTDs on dedicated SPI buses" - they share ONE hardware
    SPI bus with separate chip selects (pinmapping.h).
    - "LVGL UI elements" - there is no LVGL anywhere. The panel is drawn
    directly with LovyanGFX.
    - "Output Stage Verification: output states ... read back on discrete
    GPIO inputs" - there is one monitor pin, on the heater channel, used
    to measure duty at the ULN output. Not a readback of every output.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
2026-11-07 Head stops claiming a setting applied when the controller refused it
    The web UI could display a value the machine was not honouring. POSTing
    a 900 s shot cap returned "applied 1"; the Teensy refused it and kept
    25 s, and the head went on reporting 900 indefinitely. An interface
    saying something untrue about a machine with a 1500 W element on it is
    worth more than a cosmetic fix.
    The information was already on the wire - the Teensy acks every config
    frame with ok=0,why=refused - and the head was printing it and throwing
    it away.
    Now the head records what a key held BEFORE a write, and puts it back
    when a refusal arrives. The two sides end up agreeing rather than the
    head keeping a value the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
2026-11-07 The head was silently shortening the shot safety backstop
    Found because John asked why the shot cap read 30 s. Thirty was a test
    value I left behind, but the twenty-five it had been before that was the
    real problem.
    shotHandler's hard shot limit defaults to 60 s and is described there as
    a backstop rather than a brew setting - the one stop condition with no
    sensor behind it. The head pushes that limit under upstream's
    brew.by_time.target_time key, whose upstream default is TARGET_BREW_TIME
    = 25 s. The head is master, so at every handshake it quietly cut the
    controller's 60 s safety ceiling down to a normal shot length, which
    would also abort a legitimate 35 s lungo.
    The root cause is a map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
2026-11-07 Batch the SPI bus across a redraw, and measure what that is worth
    Wraps drawMachineScreen in lcd.startWrite()/endWrite() so the bus stays
    open across a page instead of being acquired and released by each of the
    dozens of primitives a page is made of.
    Measured rather than assumed, which matters because the usual claim for
    this technique is a large speedup:
    with batching 133.6 ms per full redraw
    without 139.6 ms
    30 passes each, drawbench on the head's console
    About 4%. Real and free, so it stays, but not transformative - the
    redraw is dominated by pixel throughput, not transaction overhead. A
    full-screen clear alone is 480 x 320 x 2 = 307 KB, roughly 61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
2026-11-08 Make BACKFLUSH armable from the panel, and stop MANUAL lying
    Both found by measuring rather than reading. BACKFLUSH's tile sent
    backflush=1 cold, the controller refused it for not being armed, and
    nothing on screen said so - a tap did nothing at all. MANUAL's tile said
    "tap to stop" while tapping it switched to the readout, where that tile
    is not on screen to tap again.
    Arming is now two taps on the tile, the same two steps the console has
    always required, because this drives the pump against a blind basket and
    the MG304 has no internal relief. The armed flag is carried in telemetry
    as bfa and read from there, NOT remembered from what the head last asked
    for: the controller disarms itself a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
2026-11-08 Add a thermal model of the boiler, so the PID can be tuned at a desk
    Development happens at a desk with the Teensy, the display and two PT100
    probes reading room temperature; the boiler is in the garage with no
    seals and no plumbing. That made the PID the largest untested thing here
    with no route to testing it - a control loop cannot be exercised when
    its input never answers its output.
    1000 W into 7400 J/K losing 2 W/K: nine minutes cold to 95 C, the same
    as the real machine. Not accelerated, deliberately - scaling time
    changes what Tn and Tv mean, so gains tuned against a sped-up plant
    would not transfer. 'boilersim <C>' jumps the model instead.
    THE RISE IS ADDED TO THE REAL PROBE READIN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
2026-11-08 Raise the PID integrator clamp: 55 could not hold setpoint
    The first logged heat-up against the thermal model climbed smoothly,
    never overshot, and stopped at 93.4 C against a 95.0 setpoint - duty
    settled at 14% and the machine sat there. No fault, no overshoot,
    nothing in the log, just permanently 1.6 C low.
    SetIntegratorLimits(0, 55), from upstream's AGGIMAX, against a PID
    output range of 0-1000. So the integral term could contribute at most
    5.5% duty. At setpoint the error is zero and the proportional term
    contributes nothing, so the integrator alone has to supply the whole
    holding power - about 144 per mille bare, 86 insulated, for 95 C in a
    20 C room. Clamped at 55 it cannot, and the l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
2026-11-08 Record the measured PID response, and bank the gains
    Kp 62, Tn 52, Tv 11.5, integrator max 200. Only the clamp changed from
    upstream; the reason is in brief 9.12.
    Cold start: reached 95.0 at 700 s, peaked 95.8, unwound to 95.0.
    Settling from 90 C, the approach a machine makes after a shot: peaked
    95.80, one dip to 94.80, then 94.90 and holding within 0.1 C, with duty
    at 8.7-9.2% against 8.6% theoretical. Duty landing on the holding figure
    is what says it has settled rather than drifted.
    Not refined further on purpose. A tenth of a degree is better than this
    machine needs, and the remaining 0.8 C approach overshoot would cost
    settling time to remove - on a boiler that takes twelve minutes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
2026-11-10 Remove the load-shed interlock entirely
    The interlock refused to run the pump while the heater was on, and refused
    to heat while the pump was running, so a 2000 W element (17 A) and the pump
    could not land on one 15 A branch circuit together.
    That element is not what this machine runs. It is specified for ONE leg of
    the dual element, about 1000 W / 8.3 A, with a 24 V DC pump off its own
    supply drawing well under an amp from the mains side. The two together are
    nowhere near a 120 V outlet's limit, so the interlock had nothing left to
    protect.
    It was defaulted off on 2026-11-08 on the argument that a written, tested
    mechanism is cheap to keep. Against that: it was two gates that could never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
2026-11-10 Move the head's UI to LVGL, measured first
    The display head's UI was ~2000 lines of hand-drawn LovyanGFX. This replaces
    it with LVGL 9.6, graphs included.
    DECIDED ON MEASUREMENTS, NOT TASTE
    One page was rebuilt as a trial first - deliberately Page::Main, the readout
    plus the boiler chart, because that page already existed hand-drawn and so
    gave a genuine side by side. link.cpp, net.cpp and headConfig.cpp were
    compiled into the trial unchanged, so WiFi, the web server and the Teensy link
    were all running underneath the numbers.
    hand-drawn LVGL
    full repaint 139 ms 97 ms
    one chart sample no benchmark 11.2 ms
    static RAM 58,012 1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
2026-11-10 Add link diagnostics, and record the D0 failure they found
    The head could not talk to the Teensy while the reverse direction worked
    perfectly. The existing counters could not explain it: recv, badsum and
    malformed all count what the PARSER saw, so all three read zero both for a
    dead wire and for noise. Those have completely different causes.
    Three diagnostics, each answering what the previous one could not:
    linkraw [ms] (Teensy) raw bytes on the link UART. Separates "nothing on
    the wire" from "bytes that will not frame".
    txtest [s] (head) bit-bangs IO44 as a plain GPIO. If the Teensy then
    sees junk the wire is good and the fault is UART config; i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
2026-11-11 Backflush disarms itself, and the arming expires
    Two defects John found on the bench, both leaving the machine armed when it
    should not have been.
    1. A FINISHED BACKFLUSH STAYED ARMED. stopBackflush() cleared the cycle and
    left backflushIsArmed set, so the brew switch went on backflushing instead
    of brewing until somebody noticed. CLAUDE.md claimed the controller
    disarmed itself after a run; it did not.
    2. THE PANEL COULD NOT DISARM AT ALL. The tile arms on the first tap and runs
    on the second, and there is no third state - so once armed, the only way
    back was the serial console.
    Armed is not a neutral state. It means a short press on the brew switch drives
    a gear pump with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
2026-11-11 Record the flow-sensor decision and the autofill coupling
    Two notes, written down because the reasoning is not recoverable from the
    parts list and the conclusions constrain code nobody has written yet.
    9.17 FLOW SENSING. The DM60 Nano's data sheet is explicit that it is built
    for coffee machines with VIBRATORY pumps, mounted between the tank and the
    pump on the suction side. This machine is direct-plumbed with a gear pump, so
    that topology does not exist here, and three of its limits bite: 5 bar
    against 8-9 bar after the pump, 65 C against 90 C+ past the exchanger, and a
    0.40 l/min linear ceiling that flushes and autofill both exceed.
    It is still probably the right choice, and the reason i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
2026-11-14 Render the panel's screens on a PC, so a layout can be seen
    The head's UI is written in firmware, so until now every layout change needed a
    flash and a look at a 4 inch panel across the room. tools/uipreview builds the
    head's own uiScreens.cpp against the head's own LVGL on this machine and writes
    one PNG per screen.
    tools/uipreview/build.sh
    It compiles layout only. uiBind.cpp is deliberately absent, so there is no
    telemetry and every live value shows the placeholder text uiScreens.cpp gives
    it. The alternative would be inventing readings for a picture.
    WHAT KEEPS IT HONEST
    It uses LVGL straight out of .pio/libdeps/esp32s3 and the head's own lv_conf.h,
    and build.sh asserts the version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
2026-11-14 The panel runs the SquareLine export
    John exported the project from SquareLine Studio and the panel was flashed with
    it. His verdict: "it looks great and everything seems to be running so far."
    The export lives in ui-design/exports/ as he produced it, and the copy the
    build compiles is src-esp32s3/ui/.
    uiScreens.cpp is no longer the UI. It is untouched and still in the build
    filter, but its whole body sits inside #if UI_EXPORT_PRESENT == 0 and now
    compiles to an empty file, exactly as that structure was meant to behave.
    Deleting src-esp32s3/ui/ brings the hand-written screens back with no other
    change, which is the way back.
    uiBind.cpp is unchanged in substance, which is the whole point of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
