jrsphoto/clevercoffee-teensy/wiki/media/build_reports/Isomac_Zaffiro_frank/image7.png

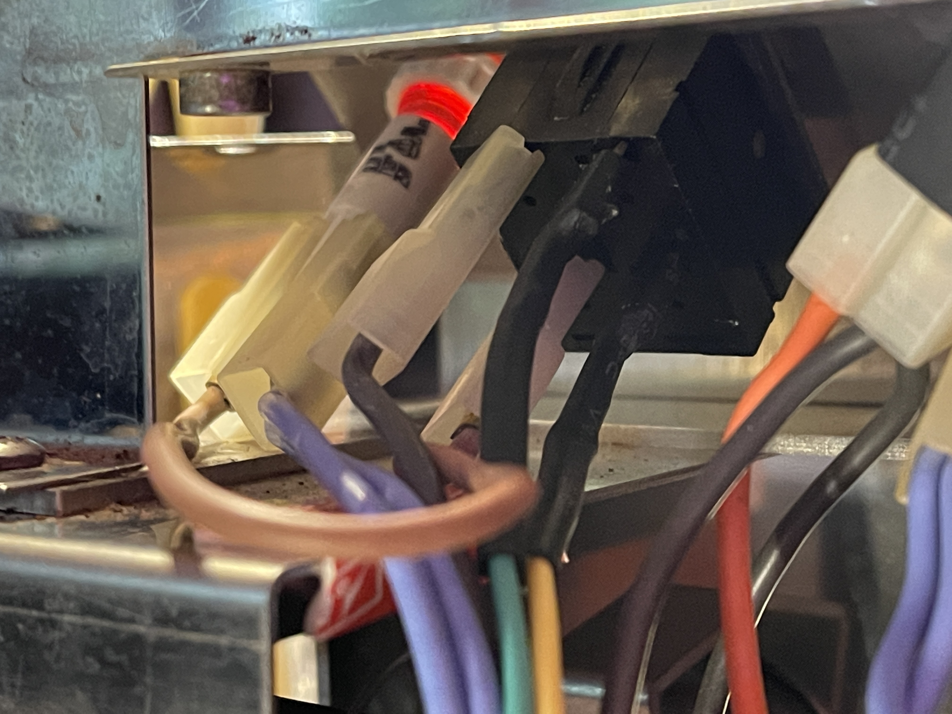
wiki/media/build_reports/Isomac_Zaffiro_frank/image7.png
