jrsphoto/clevercoffee-teensy/wiki/media/build_reports/Isomac_Zaffiro_frank/image12.png

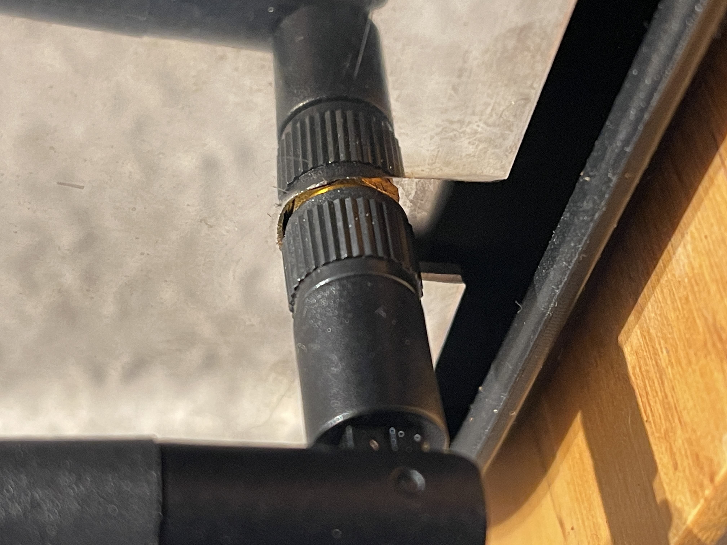
wiki/media/build_reports/Isomac_Zaffiro_frank/image12.png
